khayo/SMG/PCI/Teclado/front.png

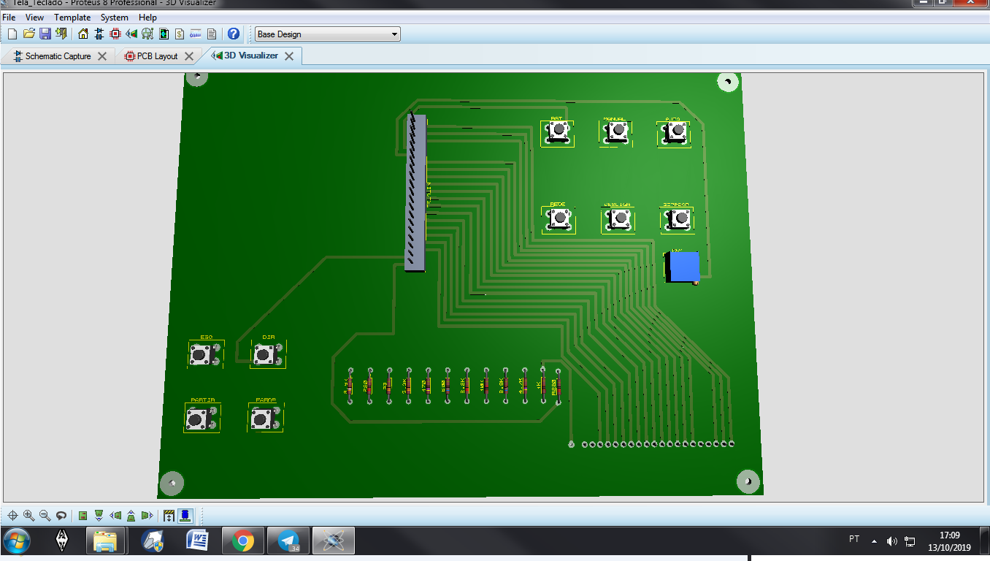
PCI/Teclado/front.png
