khayo/SMG/PCI/Teclado/PinDescription.jpg

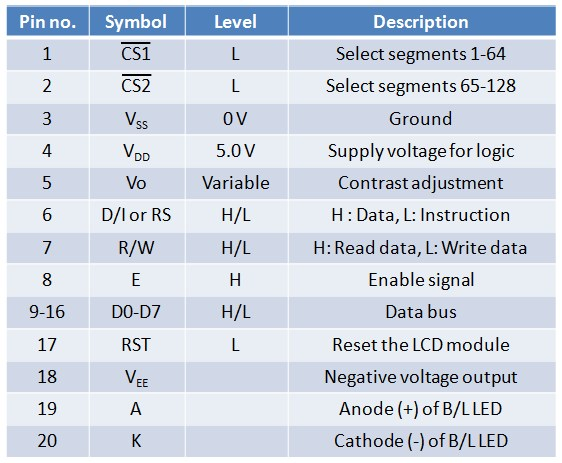
PCI/Teclado/PinDescription.jpg
