khayo/SMG/README.md

# SMG - Sistema de Monitoramento de Geradores

## Introdução

Projeto de conclusão de curso dos alunos do curso de eletroeletrônica da ETEC Lauro Gomes

## Integrantes
* Caio Pavan Lima dos Santos
* Guilheme Gil Farias Sousa
* Gustavo Vinícius de Oliveira Barros
* Khayo Vannucci Rodrigues
* Lucas Barros Silva

## Sobre o Projeto
Trata-se de um hardware de automação de geradores, tanto a parte física (placas e componente), quanto a parte lógica (software de controle) foram desenvolvidas por nós.

## Microcontrolado
Está sendo utilizadado o PIC18F4550, poís além de possuir uma grande quantidade de portas lógicas e alta velocidade de processamento (até 48mHz), possui suporte a comunicação USB, o que pode simplificar updates de Firmware no futuro.

## IDE
A IDE selecionada para desenvolver o projeto foi o MikroC devido a familiaridade dos membros com a ferramenta e a abundância de material disponível para consulta.

## Projeto Virtual
Para simulações está sendo utilizado o Software Proteus, também escolhido devido a familiaridade dos membros com a ferramenta.

## Projeto Físico
O Hardware está sendo desenvolvido em protoboard e após realização de testes de funcionamento, será montado em placa de circuito impresso.

## Monografia
Também está disponivel neste repositório a monografia, por onde mostraremos os passos do desenvolvimento do projeto.
