khayo/SMG/Programa/README.md

# SMG - Sistema de Monitoramento de Geradores
### Arquivos MikroC

Neste repositório estão armazenado o código-fonte e outros arquivos gerados pelo MikroC durante o desenvolvimento do sistema de controle.
