khayo/SMG/Simulacao/README.md

# SMG - Sistema de Monitoramento de Geradores
### Arquivos Proteus

Neste repositório estão armazenado os arquivos de projeto do Proteus.
