khayo/SMG/Academico/Monografia/README.md

# SMG - Sistema de Monitoramento de Geradores

## Monografia do projeto. 

Este é o arquivo da monografia do projeto.
