khayo/SMG/Layout/Layout_do_Modulo.png

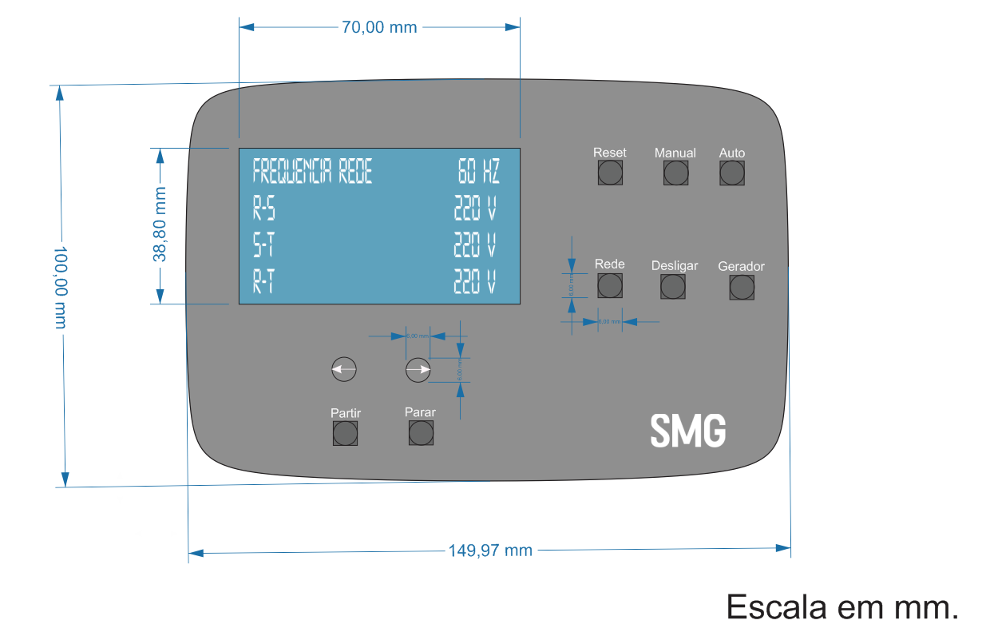
Layout/Layout_do_Modulo.png
