khayo/SMG/PCI/Teclado/1.png

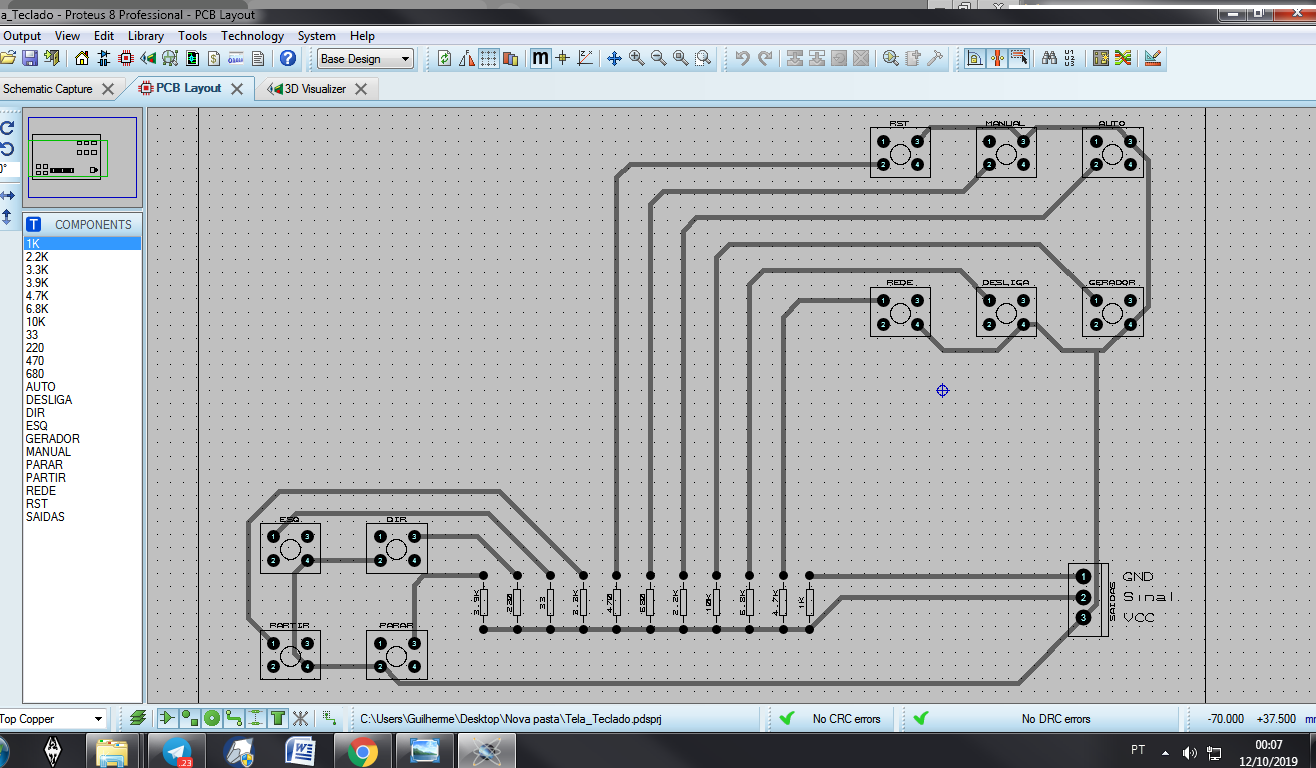
PCI/Teclado/1.png
