khayo/SMG/PCI/Teclado/back.png

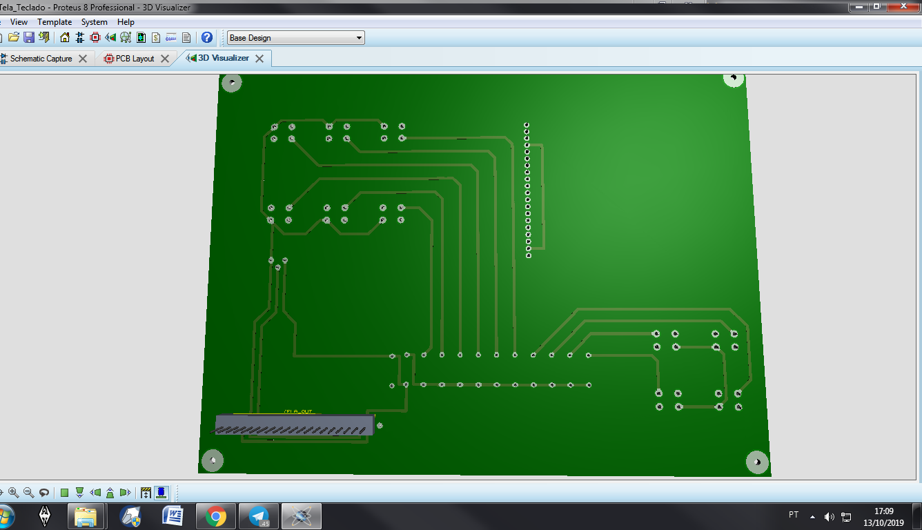
PCI/Teclado/back.png
