khayo/SMG/PCI/Teclado/layout.png

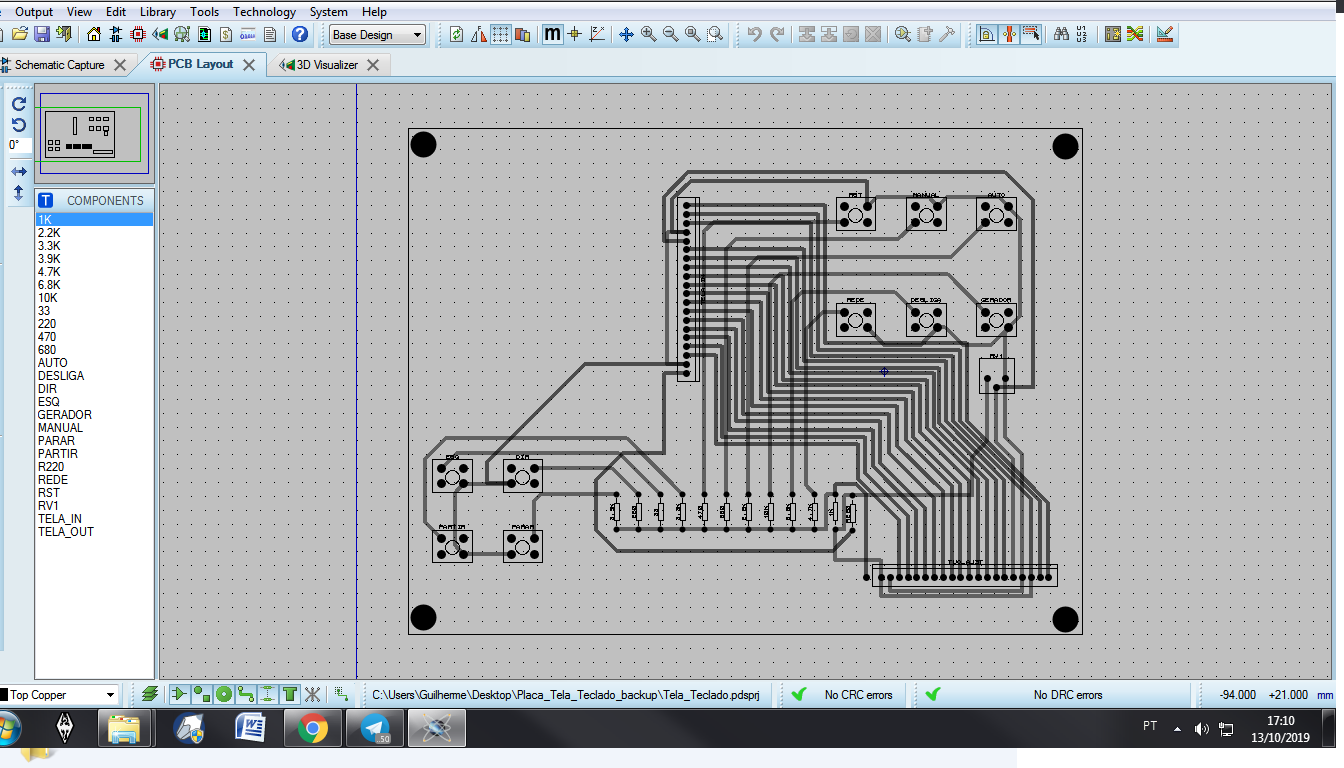
PCI/Teclado/layout.png
