khayo/SMG/Academico/Monografia/Planilha_de_Custos.xlsx

Lista de componentes
Componente | Qtd. | Valor | Subtotal
PIC18F4550 | 1 | R$31.00 | R$31.00
DISPLAY GRÁFICO K0105 | 1 | R$110.00 | R$110.00
RELE 12V | 4 | R$2.50 | R$10.00
BC548/BC549 | 4 | R$1.00 | R$4.00
DIODO 1N4007 | 4 | R$0.20 | R$0.80
PUSH BUTTON | 7 | R$0.40 | R$2.80
BOTÃO COM TRAVA | 2 | R$2.00 | R$4.00
TRIMPOT 10K | 1 | R$2.40 | R$2.40
LM35 | 1 | R$7.00 | R$7.00
LM7805 | 1 | R$1.40 | R$1.40
LM7812 | 1 | R$1.80 | R$1.80
DISSIPADOR | 2 | R$2.20 | R$4.40
PARAFUSO DISSIPADOR | 2 | R$0.30 | R$0.60
CRISTA OSCILADOR 20MHZ | 1 | R$1.00 | R$1.00
CAPACITOR CERAMICO 22PF | 2 | R$0.12 | R$0.24
CAPACITOR POLIESTER 10NF | 2 | R$0.80 | R$1.60
RESISTOR 4700 | 4 | R$0.20 | R$0.80
RESISTOR 33000 | 4 | R$0.20 | R$0.80
RESISTOR 1000 | 2 | R$0.20 | R$0.40
RESISTOR 33 | 1 | R$0.20 | R$0.20
RESISTOR 220 | 1 | R$0.20 | R$0.20
RESISTOR 470 | 1 | R$0.20 | R$0.20
RESISTOR 680 | 1 | R$0.20 | R$0.20
RESISTOR 10000 | 1 | R$0.20 | R$0.20
RESISTOR 4700 | 1 | R$0.20 | R$0.20
RESISTOR 2200 | 2 | R$0.20 | R$0.40
 |  |  | R$0.00
 |  |  | R$0.00
 |  |  | R$0.00
 |  |  | R$0.00
 |  |  | R$0.00
 |  |  | R$0.00
 |  |  | R$0.00
 |  |  | R$0.00
 |  |  | R$0.00
 |  |  | R$0.00
 |  |  | R$0.00
 |  |  | R$0.00
 |  |  | R$0.00
 |  |  | R$0.00
 |  |  | R$0.00
 |  |  | R$0.00
 |  |  | R$0.00
 |  |  | R$0.00
 |  |  | R$0.00
 |  |  | R$0.00
 |  |  | R$0.00
 |  |  | R$0.00
 |  |  | R$0.00
 |  |  | R$0.00
 |  | Total | R$186.64
