khayo/SMG/(threads)

Thread 1 (2019-10-06):

Layout do painel

khayo, 2019-10-06:
Necessário criação de layout do painel frontal do módulo contendo os botões de comando e visor. Botões presentes:

Seta para esquerda
Seta para direita
Reset
Manual
Automático
Partir
Parar
Rede
Desliga
Gerador

Em caso de dúvida, use este espaço para tirar dúvidas, dessa forma mantemos um histórico do desenvolvimento.
Caso se interesse por esta tarefa, responda esta Issue se compromentendo com sua execução. **Informar tempo necessário para desenvolvimento da tarefa.**
O layout deve ser entregue em formato de imagem, preferencialmente PNG.
Mais de uma pessoa pode se encarregar do desenvolvimento desta tarefa, tanto como um grupo, como individualmente.

Procure outros módulos ja existentes para ter uma ideia de como fazer, alguns exemplos de modulo. AMF25, HMI2011, DSE4610, DSE7410,

Conto com o engajamento de todos

DovahKrosis, 2019-10-06:
Vou tentar, só não prometo um Brad Pitt ! hehe

DovahKrosis, 2019-10-06:
tempo necessário para desenvolvimento da tarefa : 1 Hora

khayo, 2019-10-06:
Verificar tamanho do display ks0108 para que esteja na proporção correta
centralizar botões das setas
Melhorar distribuição dos botões
Agrupar corretamente os botões
Mehorar apresentação das fontes
--
Khayo Vannucci Rodrigues
11 98111-9785

Em dom, 6 de out de 2019 às 13:23, DovahKrosis <notifications@github.com>
escreveu:

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

khayo, 2019-10-06:
outros exemplos de módulo:
k30, dpc650, dkg 705

Lucfoxxd, 2019-10-07:
Feito Layout Frontal do Módulo. Está presente na pasta Layout

khayo, 2019-10-08:
OK @Lucfoxxd, acredito que [está seja a melhor disposição dos botões](https://github.com/khayo/SMG/blob/master/Layout/Layout_Frontal_do_Modulo_Lucas.png). Agora precisamos de uma versão **"em tamanho real"** com as medidas corretas dos botões e do display (ks0108). Vamos precisar mudar essas cores também, esse verde não está legal. Acho melhor uma cor mais neutra, tipo **cinza claro**. A cor do nosso **display é azul.** Acho que agora o Paint vai deixar a desejar, então procure alguém com **COMPROMISSO** e que vá te entregar essa tarefa **dentro do prazo** que escolheu para execução.

Caso alguém queira se encarregar dessa tarefa **até o fim**, informe o prazo necessário para **conclusão do trabalho.**

Lucfoxxd, 2019-10-08:
Como estou encarregado pela tarefa do layout do módulo para o Banner, então eu me encarrego desta tarefa e já adianto a outra na mesma proporção.

Prazo de entrega estimado: 12/10/19 (Sábado) até às 20h

Lucfoxxd, 2019-10-09:
Guilherme, você que tem botões, teria como me levar algum até sexta estourado?
Ou então me mandar a medida do botão que será usado no projeto (o que está na placa do layout que você executou).

khayo, 2019-10-09:
@lucfoxxd, usa o @ pra marcar e ele receber notificação

DovahKrosis, 2019-10-09:
levo um botão

Lucfoxxd, 2019-10-10:
Valeu, obrigado.
@khayo
@DovahKrosis

Lucfoxxd, 2019-10-10:
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
Atualizado Layout Frontal do Módulo. Preciso de vocês analisem e apontem melhorias o quanto antes para que eu possa colocar as medidas reais logo.
@Premone
@cplds
@DovahKrosis
@khayo

Lucfoxxd, 2019-10-10:
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
Medidas como estão por enquanto.

Lucfoxxd, 2019-10-10:
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
Atualizado Layout Frontal do Módulo. Preciso de vocês analisem e apontem melhorias o quanto antes para que eu possa colocar as medidas reais logo.
@Premone
@cplds
@DovahKrosis
@khayo

Lucfoxxd, 2019-10-10:
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
Medidas como estão.

Lucfoxxd, 2019-10-11:
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
Atualizado Layout Frontal do Módulo. Preciso de vocês analisem o quanto antes e deem suas opiniões e veredito.
@Premone
@cplds
@DovahKrosis
@khayo

Lucfoxxd, 2019-10-11:
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
Medidas reais. Analisem um possível erro.

DovahKrosis, 2019-10-11:
Muito bom em, eu aprovo

Lucfoxxd, 2019-10-11:
Então. Isso vai ser embutido na maleta, pelo o que eu entendi. Não vai ser um módulo tipo aquele que o Khayo mostrou para nós.

Lucfoxxd, 2019-10-11:
Eu também achei pequeno, seria o tamanho da placa. Mas pelo que entendi, é isso.

Lucfoxxd, 2019-10-11:
Esperemos o que vão dizer pra finalizar essa parte e vamos ver.

khayo, 2019-10-11:
Se esta imagem estiver com as proporções corretas, pode até mesmo diminuir a largura, pq ele está com aparência de achatado

Lucfoxxd, 2019-10-11:
A imagem não está na proporção correta

khayo, 2019-10-11:
Aí vc me complica né jovem. Acerta essas proporções pra gente definir o que fazer

Lucfoxxd, 2019-10-11:
Okay.

Lucfoxxd, 2019-10-11:
Farei isso

Lucfoxxd, 2019-10-12:
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
Acertado as medidas corretas e agora está proporcional. Pode conferir.
Escala em milímetros, mas, é só voltar uma casa decimal que é centímetro.

DovahKrosis, 2019-10-12:
Muito bom em mano, as proporções estão legais

Lucfoxxd, 2019-10-12:
Na outra tava bem achatado como o Khayo disse, tava sobrenado espaço de mais.

Lucfoxxd, 2019-10-14:
E aí, tá legal? Posso botar na monografia isso?

khayo, 2019-10-14:
Pode

Lucfoxxd, 2019-10-14:
Belezinha.

khayo, 2019-10-14:
Layout entregue em 13/10/2019 e0d3a0bcce2aa6c535c58c9038718beaaf7c645f

Closed 2019-10-14.

Thread 2 (2019-10-06):

Confecção de placa de rele

khayo, 2019-10-06:
Necessário confecção de **UMA** placa de rele conforme projeto [anexo](http://dicasdopinguim.com.br/wp-content/uploads/2019/10/placa_rele.zip).
Informações adicionais:
- Material será fornecido e entregue ao responsavel pela confecção no dia seguinte do aceite
- A placa deve ter 25mmx30mm
- Os contato NA e NF devem ser os bornes laterais
- Placa deve ser feita com **CAPRIXO**, pois integrará o modelo apresentado na semana da ETE

Algumas imagens de referencia de como deve ser a aparência final da placa neste [link](http://dicasdopinguim.com.br/wp-content/uploads/2019/10/placa_rele.zip)

Em caso de dúvidas, pergunte por aqui, para que possamos manter o histórico do desenvolvimento

**Informar prazo necessário para confecção**

Lucfoxxd, 2019-10-08:
Olá pessoa a qual está atribuída a tarefa. **Mande um prazo para entrega da tarefa totalmente FINALIZADA**, lembrando que **dentro desse prazo** será feita análise (todos os membros), revisão (todos os membros) e então quando aprovado, será entregue e marcada como concluída, portanto tentem não se perder na resolução da tarefa para não atrasar o desenvolvimento das outras partes que dependem desta tarefa para serem feitas.

**Qualquer dúvida, mande aqui!**

Lucfoxxd, 2019-10-10:
@cplds

cplds, 2019-10-10:
Tenho a placa já furada e desenhada, e vou levá-la hoje para resolver algumas considerações finais antes de corroer. Caso tudo dê certo, levarei-a montada amanhã.

Closed 2019-10-18.

Thread 3 (2019-10-06):

Projetar teclado do módulo

khayo, 2019-10-06:
Após definição do layout do painel do módulo, será necessário desenvolver o teclado.
A tarefa consiste em entregar um projeto de como deve ser o PCB do teclado

Algumas especificações

- Os **valores de resistor devem aparecer** no layout **corretamente** (consultar arquivo de projeto do proteus)
- A saída do teclado para o módulo deve **ter 3 fios**: positivo, negativo e comunicação.
- Os materiais devem ser **especificados e levantados por você**
- **Não confeccionar placa**, somente o projetar o designe para que seja aprovado

Em caso de dúvidas, pergunte por aqui, para que possamos manter o histórico do desenvolvimento

**Informar tempo necessário para desenvolvimento da tarefa.** Lembre-se, que este prazo é para entraga da tarefa **FINALIZADA**, ou seja, após **testes**, **análise** do material entregue e **aprovação** dos membros do grupo, portanto considere estes passos para **definir o prazo** para **finalização da tarefa**

Lucfoxxd, 2019-10-08:
Olá pessoal a qual estão atribuídos a tarefa. **Mandem um prazo para entrega da tarefa totalmente FINALIZADA**, lembrando que **dentro desse prazo** será feita análise (todos os membros), revisão (todos os membros) e então quando aprovado, será entregue e marcada como concluída, portanto tentem não se perder na resolução da tarefa para não atrasar o desenvolvimento das outras partes que dependem desta tarefa.

**Qualquer dúvida, mandem aqui!**

DovahKrosis, 2019-10-08:
PRAZO: QUINTA-FEIRA 10hAM

DovahKrosis, 2019-10-08:
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

DovahKrosis, 2019-10-08:
Os resistores estão com os valores na placa !

DovahKrosis, 2019-10-08:
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

Atualização Layout

DovahKrosis, 2019-10-09:
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

Atualizção Layout 2

DovahKrosis, 2019-10-09:
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

Atualização Layout 3

DovahKrosis, 2019-10-09:
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

Atualização 4

DovahKrosis, 2019-10-09:
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

Atualização 5

DovahKrosis, 2019-10-09:
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

Modelo Final Layout teclado

Closed 2019-10-09.

Thread 4 (2019-10-07):

Teste de consumo

khayo, 2019-10-07:
Fiz alguns testes para verificar o consumo do módulo e os resultados foram estes
O módulo em repouso, considerando a contatora de rede ligada, apenas com o display ligado, tem o consumo de 58mA.
Ao desligar a contatora da rede, temos 73mA (isto porque a contatora de rede está acionando na porta NF do relé)
Ao ligar contatora do gerador, temos 100mA.

Para cada rele acionado temos em torno de 25mA de aumento de consumo.
Então imaginando o "pior" cenário, onde todos os relés (5) estão acionados, temos 175mA.

Os reles que temos são, pre-aquecimento, solenoide de combustível, motor de partida. Achei bastante razoável. Provavelmente teremos aumento do valor do módulo em repouso ao adicionar os periféricos de controle de tensão.

Closed 2019-10-10.

Thread 5 (2019-10-07):

Banner

khayo, 2019-10-07:
Conforme já havia previsto, teremos a necessidade de criação de um banner explicando o o que é e o funcionamento de nosso projeto. Temos na nossa pasta da monografia, aquele inicio de banner, porem precisamos adicionar informações melhores no banner. Enviei aquele manual no telegram recentemente e acredito que ele traga informações muito boas para serem adicionadas no banner. Para fazer o banner usei a ferramenta [Spark Post](https://spark.adobe.com/pt-BR/) da Adobe, que é gratuita e traz diversas ferramentas que facilitam a edição deixando um trabalho bem bonito.

Acho que podemos seguir pela linha de algo mais voltado para o **profissional/comercial** ao invés de adotar uma abordagem acadêmica. Esta tarefa ficará bastante aberta, pois trata-se de desenvolvimento criativo.

Em caso de dúvidas, pergunte por aqui, para que possamos manter o histórico do desenvolvimento

**Informar tempo necessário para desenvolvimento da tarefa.** Lembre-se, que este prazo é para entrega da tarefa **FINALIZADA**, ou seja, após **testes**, **análise** do material entregue e **aprovação** dos membros do grupo, portanto considere estes passos para **definir o prazo** para **finalização da tarefa**

khayo, 2019-10-07:
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

Lucfoxxd, 2019-10-07:
Modelo de Banner

Lucfoxxd, 2019-10-07:
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
Banner Exemplo - 1

khayo, 2019-10-08:
Ficou definido da seguinte forma a divisão das tarefas do banner:
- Caio
  - Fluxograma simplificado
  - Nuvem de tags
- Gustavo
  - Imagem do display
  - Sensores
- Khayo
  - Lista
  - Características técnicas
  - Código C
  - Proteus
- Lucas
  - Logo
  - Perspectiva de layout frontal

Fazer cada parte individualmente, e enviar para análise antes de iniciar a próxima etapa
**Não importa qual ferramenta será usada** para desenvolver sua parte, o importante é que fique **bem definido o texto** que será usado e as **imagens que serão usadas**. Caso tenha algum bloquei criativo, não exite em procurar por materiais já existentes e **pedir ajuda** para outros membros. Solicite por reunião no **Discord** para **brainstorm**.
Precisamos acabar esta parte de design o mais rápido o possível, pois a **semana da ETE** é na próxima semana e portanto precisamos disto **o mais rápido o possível**, ainda precisaremos imprimir o banner.

khayo, 2019-10-08:
Criei as pastas para gente colocar os arquivos organizados, lembrem de dar git pull antes de começar a fazer as tarefas.

@Lucfoxxd - eu havia feito uma prévia de fontes, elas estão no telegram, no canal do tcc, de uma olhada para ter uma base de qual fonte usar, este é o site de onde peguei as fontes: https://fontmeme.com/ (usei como termo de busca, fonte larga).
Sobre Layout frontal, é bom agilizar a issue #1 para que usemos a versão finalizada no banner

@cplds - este site é bem simples para fazer fluxograma, mas se você tiver outro fique a vontade: https://www.draw.io
O site de nuvem de tags que usamos foi este aqui: http://www.abcya.com/word_clouds.htm

@Premone - em relação a foto do display, não sei devemos usar uma foto real do display que dificilmente vai ficar boa ou se devemos usar um print do display do Proteus. O que você acha melhor?
Sobre os sensor, acredito que o sensor mais "legal" para colocar, seja realmente o sensor de corrente, mas procure uma foto dele pela internet que as fotos que a gente tirou vão estragar o banner.

Conforme forem desenvolvendo, já enviem na pasta para que já iniciemos as analises e montagem do banner

**Lembrando que estamos correndo contra o tempo, precisamos ter esse banner pronto para semana da ETE que será na próxima semana**

khayo, 2019-10-08:
@Lucfoxxd, não se esqueça de criar o projeto para que você tenha controle do andamento do banner

khayo, 2019-10-08:
Pessoal, achei esta [ferramenta](https://www.befunky.com) que conta com alguns efeitos grátis bem interessantes, segue algumas imagens que tratei por ele para dar uma coisinha a mais:

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

Provavelmente usarei a imagem que está apenas virada, por estar bem limpa, mas não está aquela coisa "seca"

Lucfoxxd, 2019-10-08:
Como estou encarregado pela tarefa do layout do módulo para o Banner, medidas reais e ajustes para a parte física do módulo e a logo, então eu me encarrego desta tarefa e já adianto a outra na mesma proporção.

**Prazo de entrega estimado: 12/10/19 (Sábado) até às 20h**

khayo, 2019-10-09:
Voltamos a estaca zero com este banner agora que temos que seguir o modelo apresentado pelo professor. Alguém se habilita a fazer esta coisa horrorosa?

[Modelo Banner Padrão e Definitivo LauroGomes.pptx](https://github.com/khayo/SMG/files/3706904/Modelo.Banner.Padrao.e.Definitivo.LauroGomes.pptx)
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

Lucfoxxd, 2019-10-09:
Me habilito a fazer essa tarefa.
**Prazo estimado de entrega 12/10/19**

khayo, 2019-10-10:
Maravilha. Informação adicional obtida pelo grupo da sala (whatsapp) hoje. **O banner deve ter 90cm de altura por 60cm de largura**. Qualquer dificuldade nos comunique para que não fique preso a uma tarefa por muito tempo. Se posso **sugerir**, conforme for fazendo cada  parte vá nos **atualizando com o andamento**, desta forma podemos **otimizar o processo** de analise e revisão.

Lucfoxxd, 2019-10-12:
Vou utilizar alguns dados da Monografia para preenchimento de alguns campos, como, Introdução, Metodologia, Objetivos e Referências.

Lucfoxxd, 2019-10-12:
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
A **Introdução** falta melhor elaborar o paragrafo introdutório que acrescente no segundo.
**Objetivos** retirados em parte da monografia
Os **Resultados Obtidos** eu fiquei em dúvida e queria que vocês selecionassem as melhores imagens que evidencie um resultado significativo do funcionamento até agora do módulo @khayo, acho que você melhor tem autoridade para mandar essas fotos. (Duas, três)

Lucfoxxd, 2019-10-12:
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
A **Metodologia** eu pensei de fazer um fluxograma **por exemplo**: Pesquisa --> Aplicação do conhecimento --> Falha (Sim, não) --> (Não) Tirar dúvida com professores ou pesquisar mais.
As **Referências** eu peguei do nosso projeto principal(monografia), de onde a gente tirou boa parte da teoria.
A **Conclusão ou Considerações Finais** só será feita quando todo o resto estiver feito, revisado, finalizado e aprovado por vocês todos.

Lucfoxxd, 2019-10-12:
@cplds
@cplds
@DovahKrosis

Lucfoxxd, 2019-10-12:
**Analisem criticamente o que tem até agora, críticas são muito necessárias na escrita de um projeto**
Quando eu chegar verei tudo e concluirei o resto para análise de vocês.

khayo, 2019-10-12:
"mesmo"?

khayo, 2019-10-12:
Manda um print da página toda, fica mais fácil de ver

Lucfoxxd, 2019-10-12:
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

Lucfoxxd, 2019-10-12:
Vou alterar esse "mesmo", mania de principiante. Vou melhorar o termo

Lucfoxxd, 2019-10-12:
Até daqui a pouco.

Lucfoxxd, 2019-10-13:
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

Lucfoxxd, 2019-10-13:
Ae galera conforme prometido, eu voltei. Olhem e opinem.

DovahKrosis, 2019-10-13:
ta laegal, só esse estilo ai q é estranho mas é obrigatório né

Lucfoxxd, 2019-10-15:
É o jeito. Agr só esperar o cara confeccionar.

Closed 2019-10-18.

Thread 6 (2019-10-09):

Display

khayo, 2019-10-09:
Com o teclado finalizado (#3) e revisado, agora precisamos colocar o display nesta placa. Algumas **características do display**.
- 20 pinos
- faremos somente uma ligação simples do display com o teclado e do teclado com a placa principal **(display > teclado > placa principal)**.
- a barra de pinos fica do lado **DIREITO** do display
- o modelo do display é o **ks0108**
- **já existe gnd e Vcc** chegando na placa do teclado, não há necessidade de duplicar este sinal.
- o display conta com um **botão com trava para ligar o led de fundo** e um **trimpot para controle de intensidade** deste mesmo led. Podemos **embutir** estes controles na placa do teclado ou colocar na placa principal. Hoje o trimpot que está sendo usado é do **tipo de precisão**, podemos alterar para o modelo que é mais comumente usado para esta aplicação. Em relação ao botão de ligar o led de fundo, podemos trocar por uma **mini-chave liga/desliga**.

Agora precisamos decidir como vai ser a ligação da placa do teclado com a placa principal. Ou fazemos uma **ligação por cabo**, ou podemos ligar as placas como se a placa do teclado fosse um **cartucho (macho) ligando na placa principal (fêmea)**.  Precisamos levantar os **prós e contras** destes modelos de conexão ou ainda **levantar outras possibilidades** de ligação.

### Em caso de dúvidas, pergunte por aqui, para que possamos manter o histórico do desenvolvimento

**Informar tempo necessário para desenvolvimento da tarefa.** Lembre-se, que este prazo é para entrega da tarefa **FINALIZADA**, ou seja, após **testes**, **análise** do material entregue e **aprovação** dos membros do grupo, portanto considere estes passos para **definir o prazo** para **finalização da tarefa**

DovahKrosis, 2019-10-10:
"faremos somente uma ligação simples do display com o teclado e do teclado com a placa principal (display > teclado > placa principal)." essa ligação com o teclado eu não entendi.

khayo, 2019-10-10:
O display vai encaixar na placa do teclado.
O teclado vai encaixar na placa principal. Só isso

DovahKrosis, 2019-10-10:
ata blz

DovahKrosis, 2019-10-11:
tempo necessário para desenvolvimento da tarefa: SÁBADO ÁS 19:00 PM

Lucfoxxd, 2019-10-11:
Acho que a ligação em cartucho seria mais interessante porque não ficaria separado as duas partes e também ficaria mais fácil integrar os dois componentes.

DovahKrosis, 2019-10-11:
Lucfoxxd e sobre o botão com trava e o trimpot ?

khayo, 2019-10-11:
Eu gosto da ideia de cartucho, porém dessa forma, ficaremos com um "quadrado", na verdade um "L", o que dificulta no caso de chegarmos no ponto de criar a "caixa" para o módulo, e até mesmo para colocar o módulo na maleta. Apesar de que, podemos ligar como cartucho e converter para uma ligação de fio caso seja necessário. Levantei mais dúvidas do que soluções. Em resumo, acredito que a melhor solução seja mesmo a ligação "**cartucho**" pela **versatilidade**.

### O **prazo** para manifestação de opinião vai até **amanha as 15h****, após esse horário vou considerar o debate como **encerrado** e quem não participou como concordou com a maioria.

@DovahKrosis, adicione a placa, 4 furos para fixação de parafusos. Acredito que 5mm das bordas seja o suficiente e **DIAMETRO** de 3mm.

DovahKrosis, 2019-10-11:
Vou adicionar os furos, e esperar os comentarios restantes

Lucfoxxd, 2019-10-11:
@DovahKrosis
Pode ser usado essa chave liga e desliga. Se usasse o botão ocuparia menos espaço e seria mais viável?

Lucfoxxd, 2019-10-11:
Então @Khayo. Se utilizasse essa ligação em fio, caso a maleta for em acrílico, daria pra mostrar cada parte do componentes, mas teria fio rondando.

khayo, 2019-10-11:
A ligação de "cartucho" fica bem flexível, pq nada impede que seja ligado por jumpers tb

khayo, 2019-10-11:
Você e o @dovahkrosis vão ter que fazer esta parte em conjunto  para que isso funcione

Lucfoxxd, 2019-10-12:
Nesse caso então definido por cartucho.

DovahKrosis, 2019-10-12:
pessoal como apareceu ai eu criei **a pasta que conterá layout final da placa "Teclado/Tela"**, os layouts que antecederão a versão final serão colocados aqui, **se poderem opinem sobre** .

DovahKrosis, 2019-10-12:
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

**V1**

DovahKrosis, 2019-10-12:
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

**V2** O que vocês acham ?

khayo, 2019-10-12:
altere o tamanho da placa para o tamanho de placa que temos disponível (15x10)

khayo, 2019-10-12:
Alguns pontos para correção.

- Como disse na abertura da Issue, a placa ja possui Vcc e GND, logo **NÃO HÁ NECESSIDADE**  de existir o pino Vcc e GND em **duplicidade**.
- Conferir se os pinos do display estão corretos (KS0108)
- Colocar os nomes dos pinos
- Falta controle de contraste
- Falta chave de liga e desliga do backlight do display

khayo, 2019-10-12:
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

Lucfoxxd, 2019-10-12:
Na colocação do Dissipador de calor não vai interferir na montagem né?

khayo, 2019-10-12:
dissipador?

DovahKrosis, 2019-10-12:
Confira:
ENTRADAS DE TENSÃO: **VCC, VO, VEE, LED+.**

ENTRADAS **GND: GND, LED-.**

**O CONTROLE DE LUZ DE FUNDO FAZ NOS PINOS LED+/LED-?**
Eu não tenho o esquema de ligação da tela, mas se isso estiver certo da para fazer.

khayo, 2019-10-12:
http://embedded-lab.com/blog/lab-20-interfacing-a-ks0108-based-graphics-lcd-part-1/

DovahKrosis, 2019-10-12:
O prazo de entrega do layout da placa será redefinido quando tivermos as proporções da nova placa de fenolite dupla face.

khayo, 2019-10-14:
Vou procurar uma empresa de Santo André para fazer o orçamento da placa. Dependendo do valor vou mandar fazer

Lucfoxxd, 2019-10-14:
OK, avisa nós.

khayo, 2019-10-14:
Muito caro, R$850. Estou indo na santa Efigênia comprar fenolite dupla face maior pra fazer a placa na mão

khayo, 2019-10-14:
Tá na mão, vou tentar fazer hj a noite

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
![Uploading 20191014_134207.jpg…]()

Lucfoxxd, 2019-10-15:
Tranquilo!
14 out. 2019

khayo, 2019-10-18:
Estou procurando papel fotográfico para comprar, porém só encontrei papel fotográfico para impressora jato de tinta, acredito que não vai funcionar com este tipo de impressão. Quando conseguir o papel passo novas informações do andamento

Closed 2019-12-24.

Thread 7 (2019-10-10):

Controle de atualização

khayo, 2019-10-10:
Vou usar esta issue como controle de atualizações, desta forma podemos manter um histórico de fácil leitura das alterações realizada. A partir da próxima postagem, já começarei a listar as mudanças feitas, tentarei linkar ou intercalar a postagem com o commit realizado, não sei se é possível. Fiquem a vontade para tirar dúvidas ou sugerir melhorias.

khayo, 2019-10-10:
Realizei pequenas alterações no código para que o funcionamento no hardware ficasse dentro do esperado:
- Alteração do cálculo de temperatura
- Correção do posicionamento da exibição dos valores de calibração dos botões
- Travamento dos botões de navegação durante a calibração
- Melhoria na ativação do modo de calibração

khayo, 2019-10-10:
Ok, é possível referenciar o commit e intercalar com as postagens. Conseguiremos uma boa forma de controle. Estou também criando um projeto para que seja possível definir as tarefas necessárias (TODO)  para continuidade do desenvolvimento.

Lucfoxxd, 2019-10-10:
Continuo na mesma função desse projeto que você está criando?

khayo, 2019-10-11:
Você vai gerenciar e me cobrar como combinamos. Este final de semana estipularei os próximos passos a serem executados e pretendo ter um bom avanço para que tenhamos algo concreto para apresentar da semana. Peço a gentileza que não tire o "pinagem" desta Issue para que ela fique sempre na parte de cima da página.

khayo, 2019-10-11:
Fiz a compra de alguns componentes que prevejo que utilizaremos em brave, entre eles:
- Conectores DB25 macho e fêmea para PCI e para soldar fios. Acredito que esta será a interface entre nosso simulador e nosso módulo. (_090 L, M, N, O_)
- Barra de pinos fêmea 40 vias, para comunicação da placa principal com teclado (_090 H_)
- Barra de pinos macho 40 vias 90º para comunicação do teclado com a placa principal (_090 I_)
- Push Button Longo, além de facilitar os testes de protoboard, quando fecharmos o módulo, prevejo que eles serão necessários para que seja possível aperta-los. (_008_).
- Trimpot horizontal de 10, para controle da contraste do display, que será colocar na placa do teclado, caso seja definido que o trimpot ficará na placa do teclado. (_203B_)
- Separei do estoque a chave de liga e desliga para o led de fundo do display (_133_)

Em relação a parte lógica, não fiz nenhum progresso, pois com a chegada dos componentes, gastei um tempo adicionando os itens ao sistema.
Algumas fotos dos componentes e dos botões longos instalados na protoboard.
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

DovahKrosis, 2019-10-11:
muito legal esses push buttons altos

khayo, 2019-10-12:
Identifiquei quais são as rotinas prioritárias para o desenvolvimento do módulo e as coloquei no projeto "desenvolvimento principal".

Também fiz um levantamento das portas que estão sendo usadas e de quais portas estão disponíveis, e felizmente teremos portas o suficiente para continuar o desenvolvimento sem a preocupação de necessitar de mais portas (digitais e analógicas).

Estava fazendo algumas verificações no hardware e aconteceu algo estranho, o processamento estava acontecendo extremamente lento, isto nunca havia acontecido e fiz uma pequena revisão nas ligações e identifiquei uma conexão de fios positivos e negativos que não estavam muito bem encaixados. recoloquei os cabos e parece que está ok agora. Durante esta verificação notei que o LM35 foi ligado de maneira incorreta. Ainda não fiz a ligação correta, porem acredito que este seja o motivo da temperatura não estabilizar no display e também de existir divergências nos cálculos que deveriam ser feitos e os cálculos que estão sendo feitos.

Farei a correção do circuito e farei algumas alterações de portas usadas para que fiquem disponíveis portas analógicas para alguma eventualidade.

khayo, 2019-10-12:
Durante a revisão do projeto, notei que o cálculos que fiz para o divisor de tensão do sensor de tensão VCC estavam errados, na verdade estavam para o valor de 20v. Refiz os cálculos e alterei o divisor de tensão

khayo, 2019-10-12:
Finalizei a revisão da protoboard.

- Refeita ligações dos reles já instalado
- Feita ligação dos reles que não estavam instalados
- Correção das ligações do sensor de temperatura
- Correção dos cálculos e circuitos do divisor de tensão
Esta é a protoboard agora
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

Na primeira ligação houve um problema de funcionamento devido a ligação invertida do lm35. Aparentemente não houve dano aos componentes.

khayo, 2019-10-12:
Notei que após o módulo ficar parado em uma tela por um determinado tempo, os botões de navegação param de funcionar corretamente. imagino que seja algum tipo de excesso de processamento. Vou tentar descobrir o que está ocasionando a falha, após implementar algumas funções indispensáveis para a demonstração

khayo, 2019-10-12:
Após o envio do código sem comunicação serial, houve uma melhora no desempenho e o sistema parou de travar. Para o propósito do TCC, deixaremos esta função desativada.

khayo, 2019-10-12:
Atual disposição das portas:

2   - Sensor de temperatura (RA0)
3   - Botões (AN1/RA1)
4   - Sensor de tensão continua (AN2/AN2)
5   - Rele - pre-aquecimento (RA3/AN3)
6   - Rele - Solenoide (RA4)
7   - Rele - Motor de pártida (RA5/AN4)
8   - Rele - Gerador (RE0)
9   - Rele - Rede (RE1)
10  - Livre (RE2/AN7)
15  - Livre (RC0)
16  - Livre (RC1)
17  - Emergência (RC2)
23  - Livre (RC4)
24  - Livre (RC5)
25  - TX
26  - RX

Lucfoxxd, 2019-10-12:
Muito bom
Tem bastante informação pertinente para adicionar à monografia.

khayo, 2019-10-12:
Estou fazendo teste nos reles, configurei os botões reset, manual e automático, para acionar os reles pre-aquecimento, solenoide e motor de partida. Os reles solenoide e motos de partida estão funcionando como o esperado, porém o rele de pre-aquecimento está desligando ao acionar o rele de motor de partida e solenoide. A falha não se repete ao acionar o rele de rede ou de gerador. Vou verificar as ligações físicas, pois não vejo acredito que seja possível que seja uma fala de programação devido a simplicidade do código  (PRE_AQUEC = !PRE_AQUEC;)

khayo, 2019-10-12:
Outra informação importante é que o botão que liga o rele do pre-aquecimento não consegue desligar o pre-aquecimento

khayo, 2019-10-12:
Descobri o erro, o registrador ADCON1 estava configurado para portas analógicas de AN0 até AN3. Como fiz as alterações nas portas, a porta RA3 estava configurada como analógica, quando deveria ser digital. Fiz as alterações e está funcionando como esperado.

khayo, 2019-10-13:
O funcionamento "básico" do módulo está finalizado. Agora vem a parte de monitoramento de energia, que farei pelo Arduíno.

khayo, 2019-10-18:
Realizei alguns testes nos circuitos do projeto que estavam a algum tempo parados (gerador de função e comunicação serial) para verificar se estavam funcionando corretamente e está tudo funcionando como esperado. A partir de segunda me dedicarei a leitura de tensão, corrente e frequência de rede, espero no próximo final de semana trazer resultados concretos sobre o desenvolvimento desta parta.

khayo, 2019-10-19:
Durante o dia estive pensando nos materiais que teremos que comprar. Da parte de eletrônica, acredito que não tenha mais nenhum material para comprar, mas para a parte de elétrica, teremos que providenciar algumas coisas.
- [Contatoras WEG CAW04](https://produto.mercadolivre.com.br/MLB-1225736458-minicontator-weg-cawm4-40-00v26-220v-60hz-10045381-_JM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) (3 unidades).  (aquelas eram da AGESP, não podemos contar com elas)
- [Base Soquete para Rele](https://produto.mercadolivre.com.br/MLB-1220465906-base-soquete-porta-rele-5-4-pinos-40-amp-montavel-_JM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) (2 unidades)
- [Reles Automotivos](https://produto.mercadolivre.com.br/MLB-769337686-rel-auxiliar-automotivo-universal-12v-3040a-5-pinos-preto-_JM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) (2 unidades)
- Acrílico, acredito que o @DovahKrosis consiga pra gente

Hoje comprei uma peça para consertar minha impressora a laser, as peças devem chegar no meio da semana que vem, assim posso trabalhar com as PCI mais tranquilamente e sem a preocupação de ocorrer alguma falha no processo de impressão, perdendo o dia de trabalho.
O papel fotográfico estou estudando qual traz um melhor resultado, encontrei dois lugares que recomendaram o [Papel Fotográfico Epson 95g High Quality Inkjet S041117 100Fls](https://www.kalunga.com.br/prod/papel-especial-95g-high-quality-inkjet-fosco-s041117-epson/478693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). Pretendo comprar amanhã durante o dia.

Vi um vídeo ensinando como criar protocolos de comunicação, achei bem interessante e relativamente simples, se tivéssemos mais tempo, seria bem legal desenvolver um protocolo próprio, não por necessidade, mas pelo aprendizado. Então, continuamos com a comunicação serial mesmo, vou dar uma revisada no código do protótipo de comunicação e tentar fazer a comunicação propriamente dita.

khayo, 2019-10-20:
Ontem chegaram as peças da impressora laser que precisava ser arrumada. Troquei as peças e apanhei o dia todo dos drivers da impressora, mas finalmente deixei funcionando decentemente. Algumas fotos dos resultados:

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

Próximo passo é comprar o papel fotográfico, farei isto semana que vem, estou duro.

khayo, 2019-10-20:
O GitHub decidiu que vai colocar a foto de cabeça pra baixo, vai entender..

khayo, 2019-10-22:
Conversei com o Plez ontem, temos até o fim do mês de novembro para apresentar, podemos apresentar antes, o que provavelmente é uma ótima ideia, vou acelerar o desenvolvimento. FAÇAM ALGUMA COISA.

khayo, 2019-10-24:
Para melhorias futuras

https://youtu.be/oi3PKpMxIF8

khayo, 2019-10-26:
Comprei o papel para fazer as placas, vou revisar o layout e fazer os primeiros testes.
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

khayo, 2019-10-28:
Fiz a primeira placa pelo processo de transferência, os resultados não foram dos melhores, mas deu pra entender os pontos que precisam ser melhorados. Se usar o ferro frio, não transfere, muito quente corre o risco de danificar a placa. Além disso, mesmo com a placa dando errado, notei que seria bom aumentar o tamanho das trilhas, elas não ficaram ruins, mas alguns pontos poderiam não ter dado certo e se na placa for necessário fazer algum acerto com caneta antes da corrosão, com a trilha mais larga ficará mais fácil.
Notei tb que fazer cada lado individualmente provavelmente não vai dar certo. Agora como fazer as duas ao mesmo tempo vai ser um desafio, ainda estou pensando em uma solução.

No geral as ilhas ficaram muito boas, exceto algumas trilhas dos botões, mas nada que fosse impossibilitar o uso da placa.

Acredito que durante a semana eu consigo fazer a placa.
Algumas fotos de como ficou.
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

khayo, 2019-10-28:
Fiquei pensando em como fazer para transferir os dois lado de uma vez, e pensei no furo guia, já tinha antes mas acabou sumindo por algum motivo, e agora tem de novo. Além disso coloquei um jumper  no trimpot de contraste, achei que assim ficaria melhor para soldar na barra de pinos.

DovahKrosis, 2019-10-28:
ou na placa ta escrito Janeiro 2017, não é 2018 ???

khayo, 2019-10-29:
> ou na placa ta escrito Janeiro 2017, não é 2018 ???

Fiz a alteração conforme o commit 5fe8169. Iniciei o processo de manufatura da placa, hj corte e limpei. Pretendo amanhã fazer as trilhas e corroer.

Closed 2019-12-24.

Thread 8 (2019-10-12):

Arquivos em duplicidade

khayo, 2019-10-12:
Pessoal, estamos em uma plataforma de c**ontrole de versão**, pelo amor de deus, **não dupliquem arquivos**, caso queira fazer alguma alteração, simplesmente faça a alteração e envie para o github. Caso seja necessário restaurar o arquivo como ele estava anteriormente é possível fazer isso através do git. Ao duplicar arquivos, além de grandes chances de essas versões se perderem na linha do tempo, perdemos o controle de versão do arquivo, ainda ocupamos espaço desnecessariamente.

Closed 2019-10-18.

Thread 9 (2019-10-15):

Apresentação na semana da ETE

Lucfoxxd, 2019-10-15:
Temos algumas especificações para a apresentação do projeto na semana da ETE que será realizada no dia 16/10/19, quarta-feira:

1. O banner será apresentado na direção junto com uma apresentação referente ao projeto, onde os professores vão dar a nota numa ficha que deveremos imprimir, preencher a nossa parte e levar para eles preencherem o resto.

2. Será necessários pelos menos duas ou três pessoas na direção para apresentação aos professores **segundo o Fialho**. As pessoas que não estiverem na diretoria, estarão no bloco 5 explicando o projeto, eu **sugiro imprimir algumas fichas que fizemos referentes ao projeto para nortear a apresentação** quem for ficar na sala do bloco 5 para entregar as pessoas.

3. Salas em que vão ficar no bloco 5 e os professores que vão avaliar, se informar qual das salas vão ficar, segue a imagem:
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

4. Cada grupo tem que receber no mínimo três avaliações de três professores onde essa ficha será passada ao orientador que é o Plez.

5. Devemos imprimir 3 conjuntos dessas fichas **segundo informações passadas pelo Whatsapp** para que os professores possam gerar a notas.
Segue as folhas da ficha:

**Folha 1**
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

**Folha 2**
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

**Folha 3**
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

6. A tarefa atribuída será definir **quem irá ficar no bloco 5 e os temas que serão divididos para apresentar aos professores tanto na diretoria quanto no bloco 5**, pois se  todos tiverem que apresentar juntos por algum problema, todos sabem o conteúdo/falas e o que está acontecendo exatamente em ambos os locais da apresentação.

**7. Como o prazo está super apertado, a urgência é definir tudo até amanhã o mais cedo possível para ter tempo de ensaiar a apresentação e evitar erros desnecessários.**

khayo, 2019-10-15:
Por mim tanto faz, eu to tranquilo quanto a apresentação, pode me mandar onde for mais complicado

Lucfoxxd, 2019-10-15:
Tudo bem então. Vou separar.

Lucfoxxd, 2019-10-15:
Fica eu, Khayo e mais uma pessoa para apresentar na banca para os professores.
O Guilherme sugeriu a seguinte:
Lucas, Khayo e Gustavo para os professores.
Caio e Guilherme lá na diretoria.
Eu concordo com essa divisão.

Sobre as questões que foram apresentadas ontem, a dúvida de apresentar todo mundo junto ou não é uma possibilidade de acontecer.

Vou dividir os seguintes temas que ficará tanto pras três pessoas quanto para as duas (tentar apresentar em pelo menos 15 minutos pra não ficar cansativo):

1 INTRODUÇÃO
2 OBJETIVOS
3 METODOLOGIA
4 PROBLEMAS RESOLVIDOS, ENCONTRADOS E DIFICULDADES EM EXECUTAR O PROJETO ATÉ O MOMENTO
5 RESULTADOS OBTIDOS ATÉ AGORA
6 CONCLUSÃO

(A divisão é simples o 6 é múltiplo de 3 e de 2 então os membros ficarão com as mesmas quantidades tanto em um bloco, quanto no outro se ocorrer isso mesmo)

**O que eu preciso de vocês agora é:**
- Quem vai imprimir uma ficha e preencher, e imprimir pelo menos uns 3 panfletos daqueles que foram feitos pelo Khayo.
- E preciso que dividam o que cada um irá falar (tanto as duas pessoas, quanto as 3), para já treinar a apresentação. (Escolham seus temas)
- E preciso também da divisão caso se todos fossem apresentar juntos. (Escolha seu tema, nesse caso, uma pessoa irá ficar com dois temas)

**Os professores irão tirar dúvidas, então quaisquer dúvidas sobre o projeto até aqui, é bom tirar o quanto antes no grupo do Telegram ou aqui mesmo na Issue**

Temos a Monografia, o arquivo do Alterações Pendentes e o Banner para se basear em conteúdo.

Lucfoxxd, 2019-10-15:
Temas Lucas Para três pessoas: Introdução e Conclusão.
Temas Lucas para 5 pessoas: Introdução

**Façam nesse modelo**

Eu já separei os meus. Se precisar mudar, nós mudamos sem problema.

Closed 2019-10-18.

Thread 10 (2019-10-18):

Resultados semana da ETE

khayo, 2019-10-18:
Primeira fase concluída, fizemos uma boa apresentação.
Vamos tirar este final de semana para descansar e pegamos forte novamente semana que vem.
Não podemos levar esta segunda fase como fizemos na primeira, todos precisaram contribuir mais ativamente no projeto para que possamos entregar o trabalho realmente concluído.

Alguns pontos que precisamos melhorar:

-**Iniciativa**: Não esperem que eu peça para que façam algo, vocês conhecem o projeto e ele também é de vocês. Vocês estão perdendo  uma boa oportunidade de aprender. Eu sei o quanto me desenvolvi nestes últimos tempos por conta desse projeto.
-**Prazos**: Temos pouco tempo, dediquem uma parte do tempo de vocês pensando em como melhorar o que apresentamos. Existem ideias idiotas, mas pelos prazos, até elas são bem vindas.
-**Qualidade**: Não podemos nos dar ao luxo de ter retrabalho. Se algo está sendo feito, faça com atenção, para fazer uma vez só.
-**Capricho**: Pode ser que este não seja o projeto que vocês tinham na cabeça para fazer, mas é este que escolhemos, quando estiver fazendo algo relacionado ao projeto, lembre do que sentiu quando recebeu elogios, queira receber mais elogios e faço um bom trabalho.
-**Pense**: Todos nós temos um cérebro, use-no para entregar um bom resultado
-**Comunique**: Somos 5 pessoas trabalhando no mesmo projeto, se não houver uma comunicação clara, termos sérios problemas. Antes de dar andamento a alguma parte do projeto que será feita por terceiros, confirme se o material que está sendo entregue ao fornecedor é o material correto para que não exista falhas na comunicação.
-**Dedique-se**: Este é o trabalho mais importante do ano, é de suma importância que se dediquem a ele.
-**Experimente**: "ah, mas eu não sei o que fazer", a vida é assim, não sabemos o que fazer mesmo, sentar e esperar cair a resposta no colo não se mostrou uma boa estratégia. Aqui, agora, vocês tem a chance de experimentar decisões com um custo muito, **MUITO** baixo. Não percam esta chance.

É isso pessoal, conto com a colaboração de todos.

Closed 2019-10-28.
