khayo/SMG/Academico/Monografia/Diagrama de funcionamento Gerador.pdf

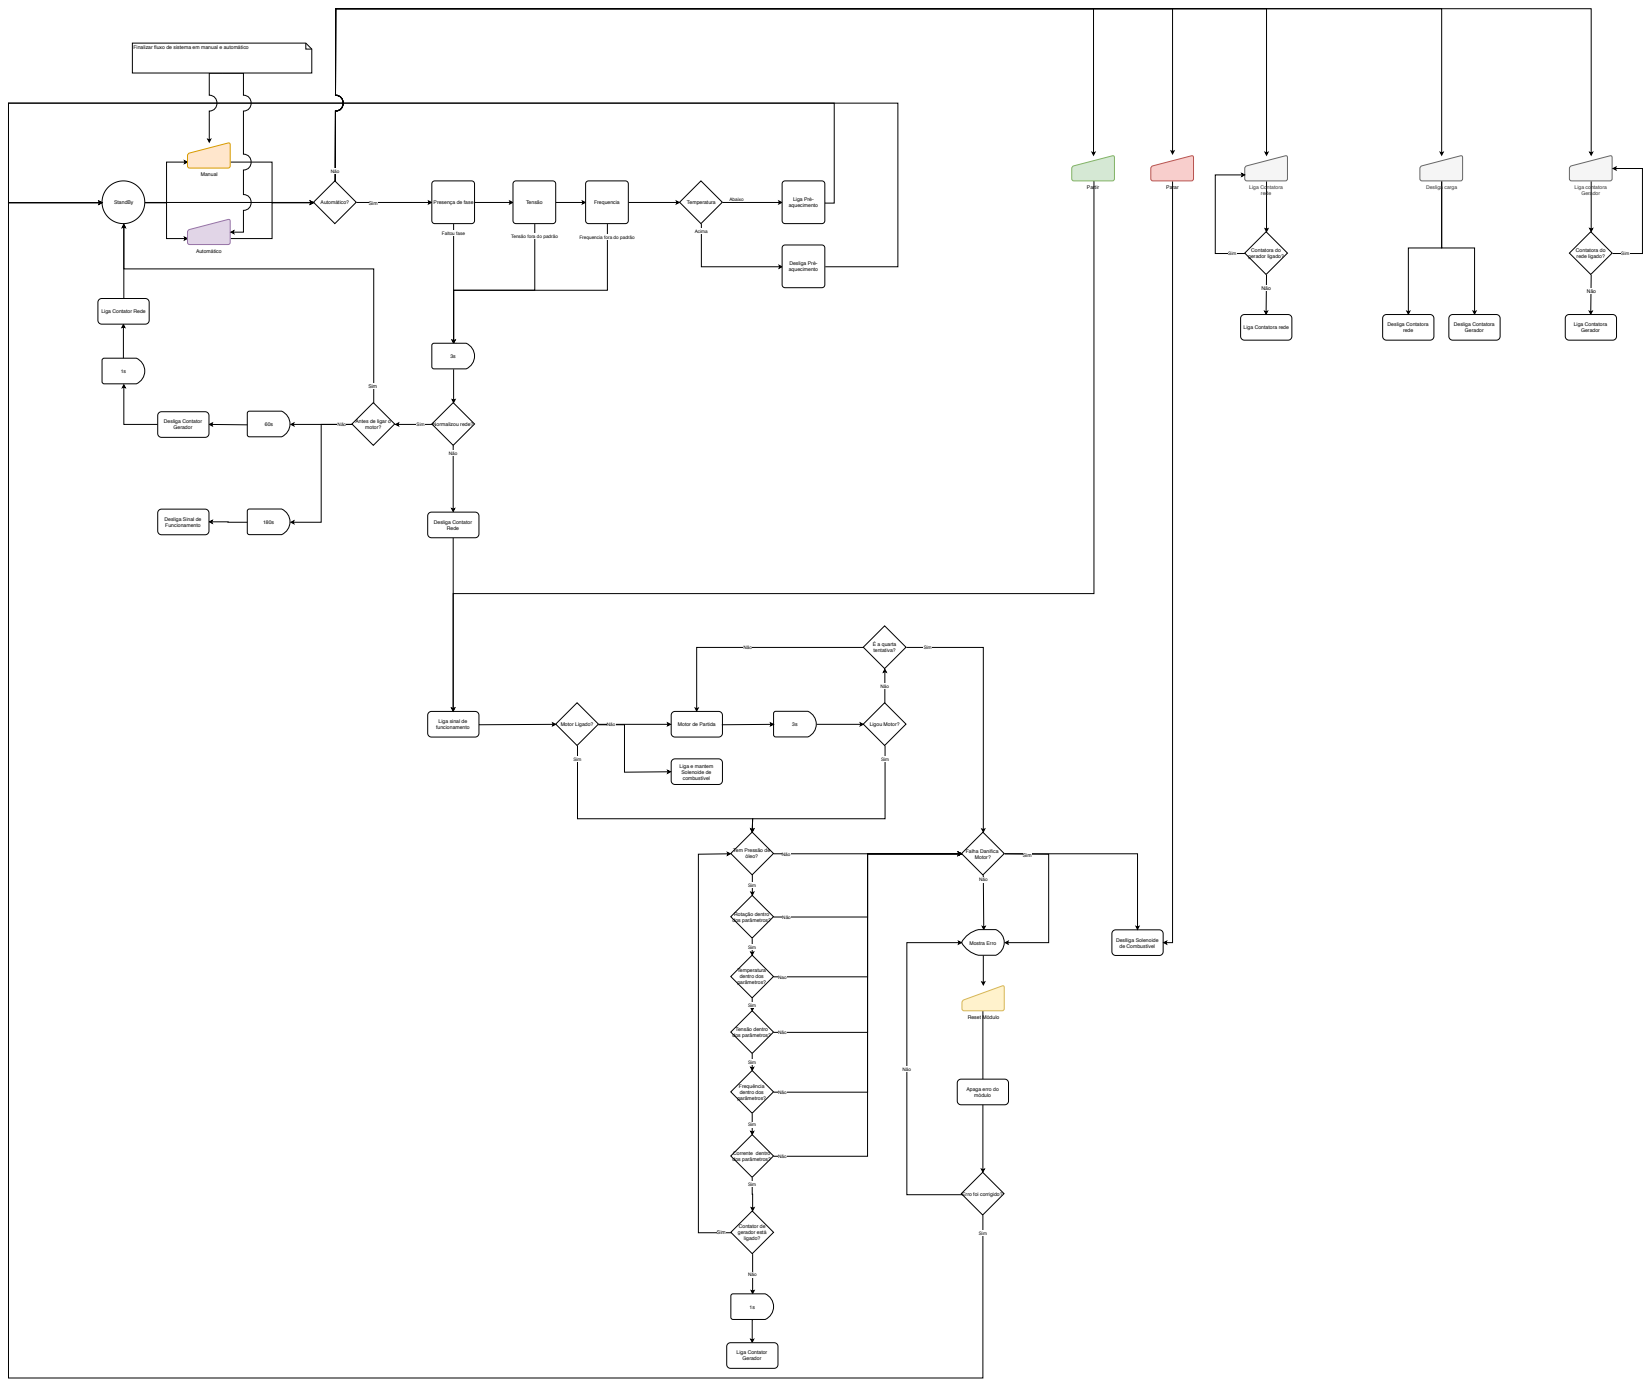
[picture p7: page 1]
Liga e mantem Solenoide de combustível; Sim; Não; Rotação dentro dos parâmetros?; Nao; Temperatura dentro dos parâmetros?; Tensão dentro dos parâmetros?; Frequência dentro dos parâmetros?; StandBy; Faltou fase; Tensão; Frequencia; Acima; Abaixo; Temperatura; Desliga Pré- aquecimento; Liga Pré- aquecimento; Falha Danifica Motor?; Deslliga Solenoide de Combustível; Normalizou rede?; Motor Ligado?; Ligou Motor?; É a quarta tentativa?; Mostra Erro; Reset Módulo; Corrente dentro dos parâmetros?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

Finalizar fluxo de sistema em manual e automático

Presença de fase

Tensão fora do padrão

Frequencia fora do padrão

Liga Contator Rede

Liga Contatora rede

Antes de ligar o

180s Desliga Sinal de
Funcionamento

Liga sinal de
funcionamento

Motor de Partida

Tem Pressão de
óleo?

Apaga erro do
módulo

Erro foi corrigido?
