khayo/SMG/(list of files, drawings)

Other design files:
PCI/Botoes/Teclado.pdsprj
PCI/Placa_rele/placarele.pdsprj
PCI/Placa_rele/placarele_copias.pdsprj
PCI/Teclado/Tela_Teclado.pdsprj
Simulacao/TCC.pdsprj
