khayo/SMG/PCI/Placa/TCC.kicad_pcb

## KiCad design PCI/Placa/TCC.kicad_pcb (2019-12-24)

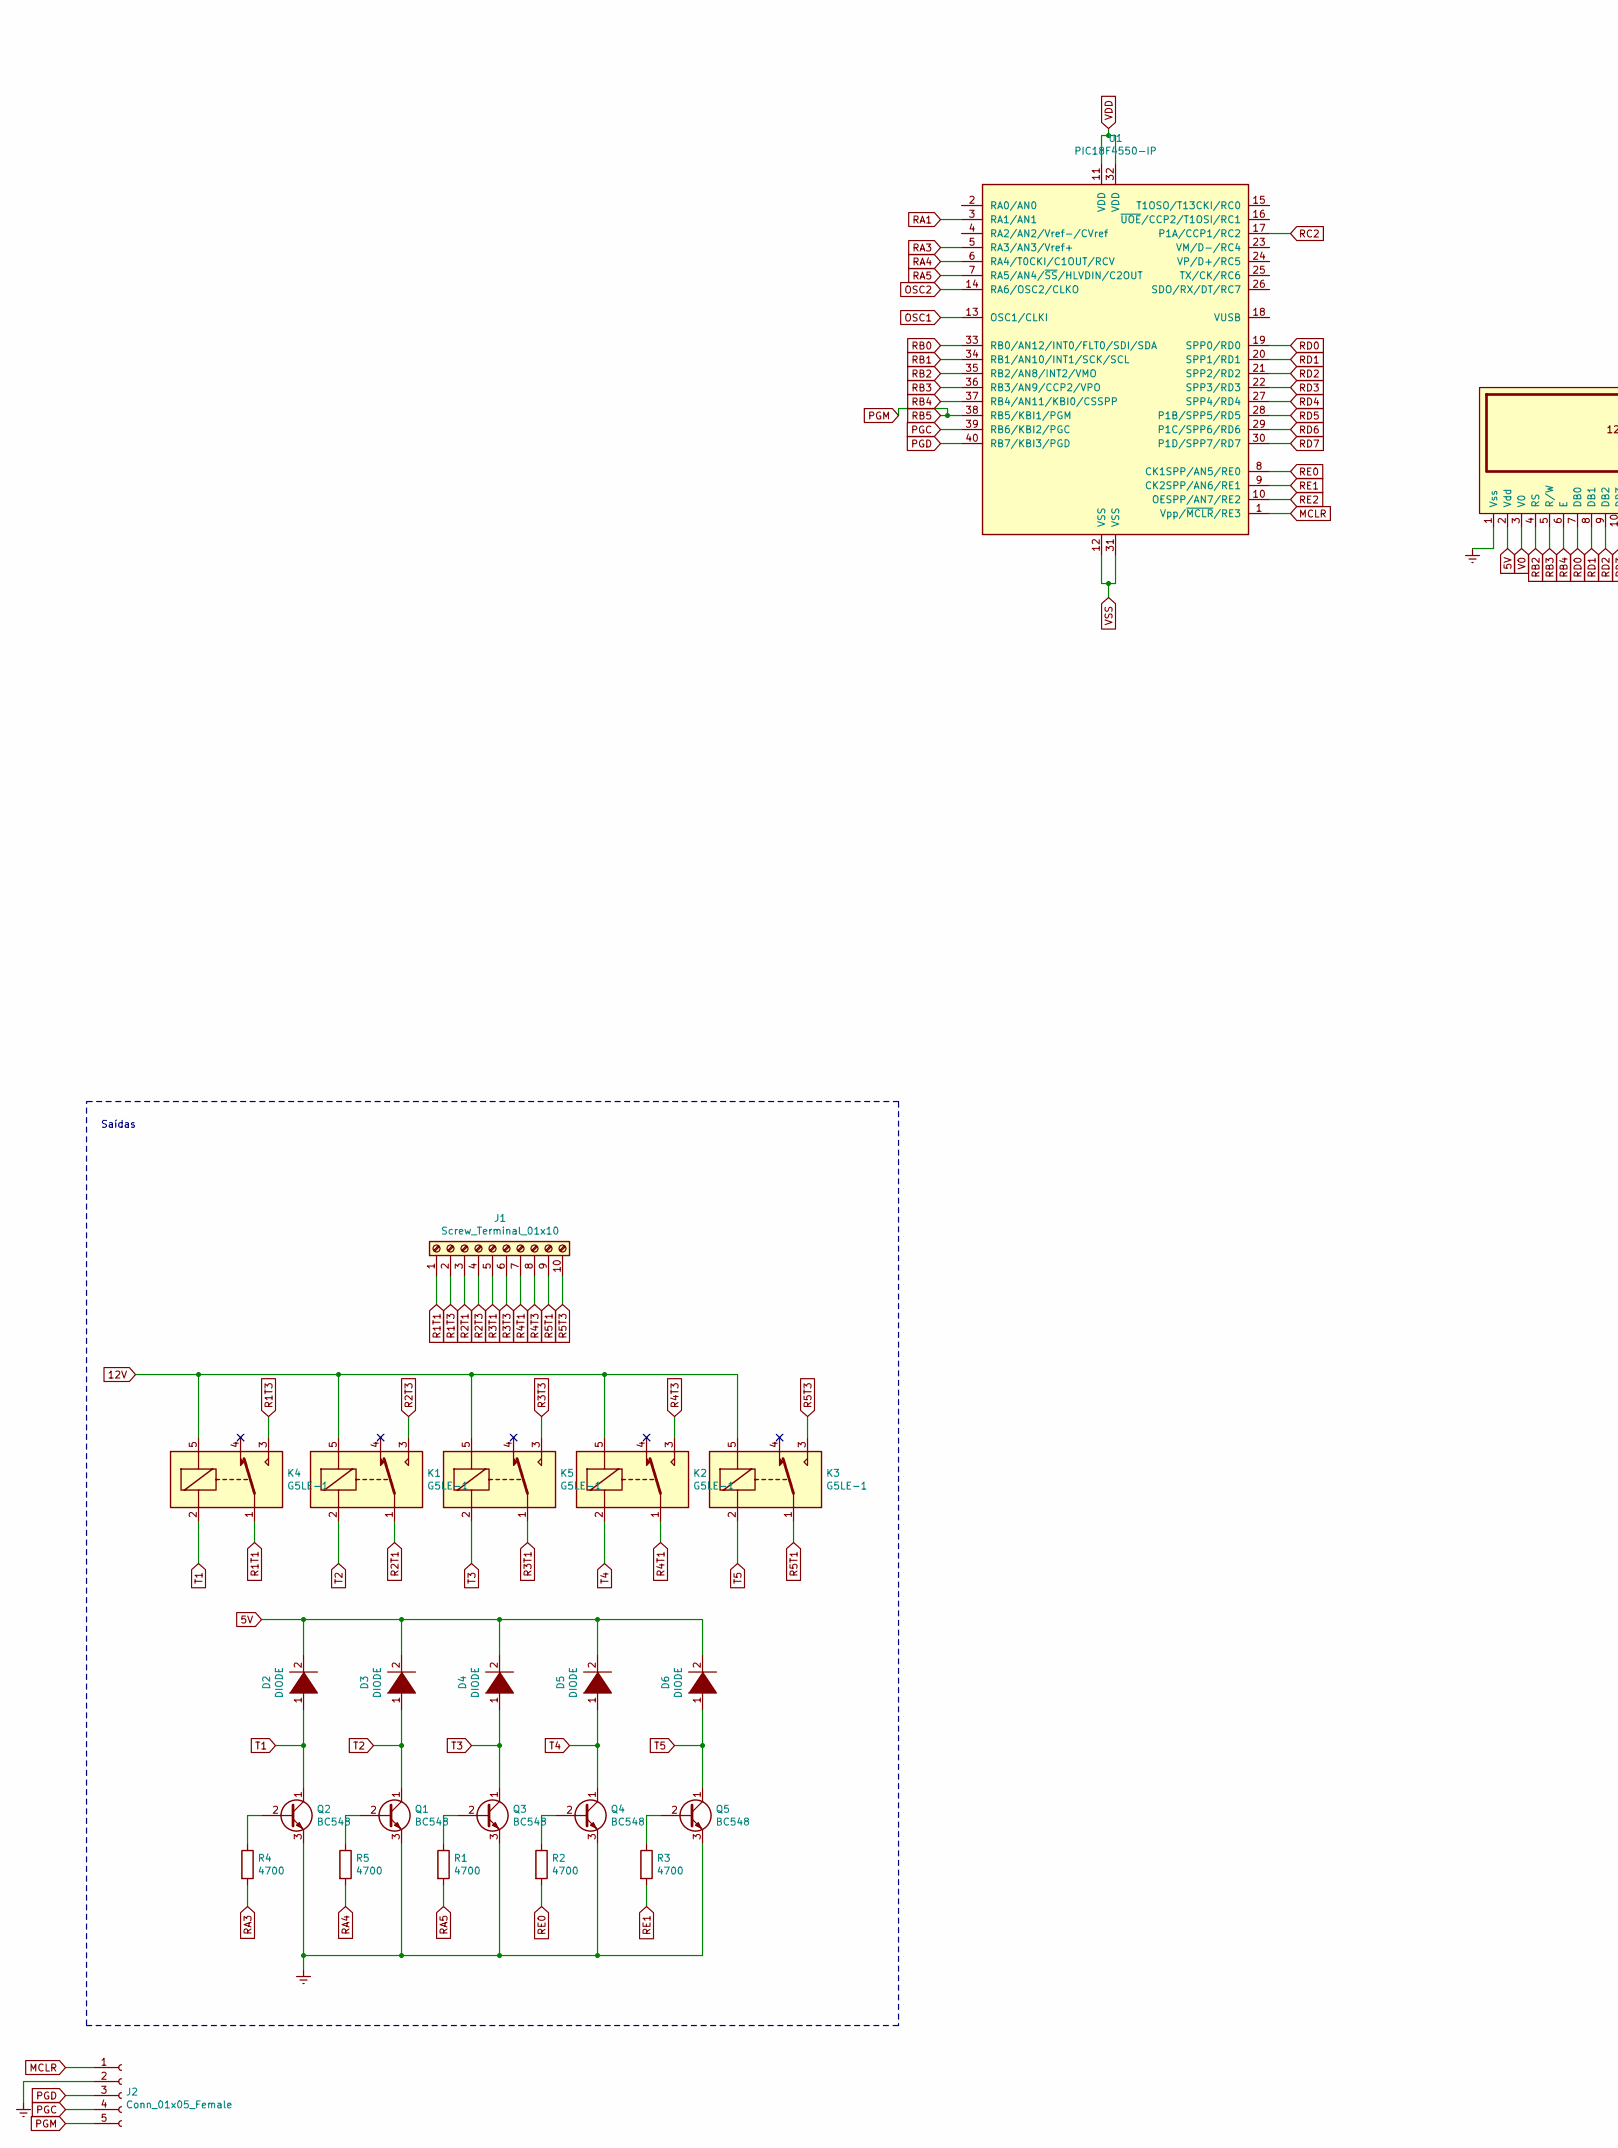
[picture p8: schematic TCC.sch, TCC Eletroeletrônica, part in row 1, column 1]

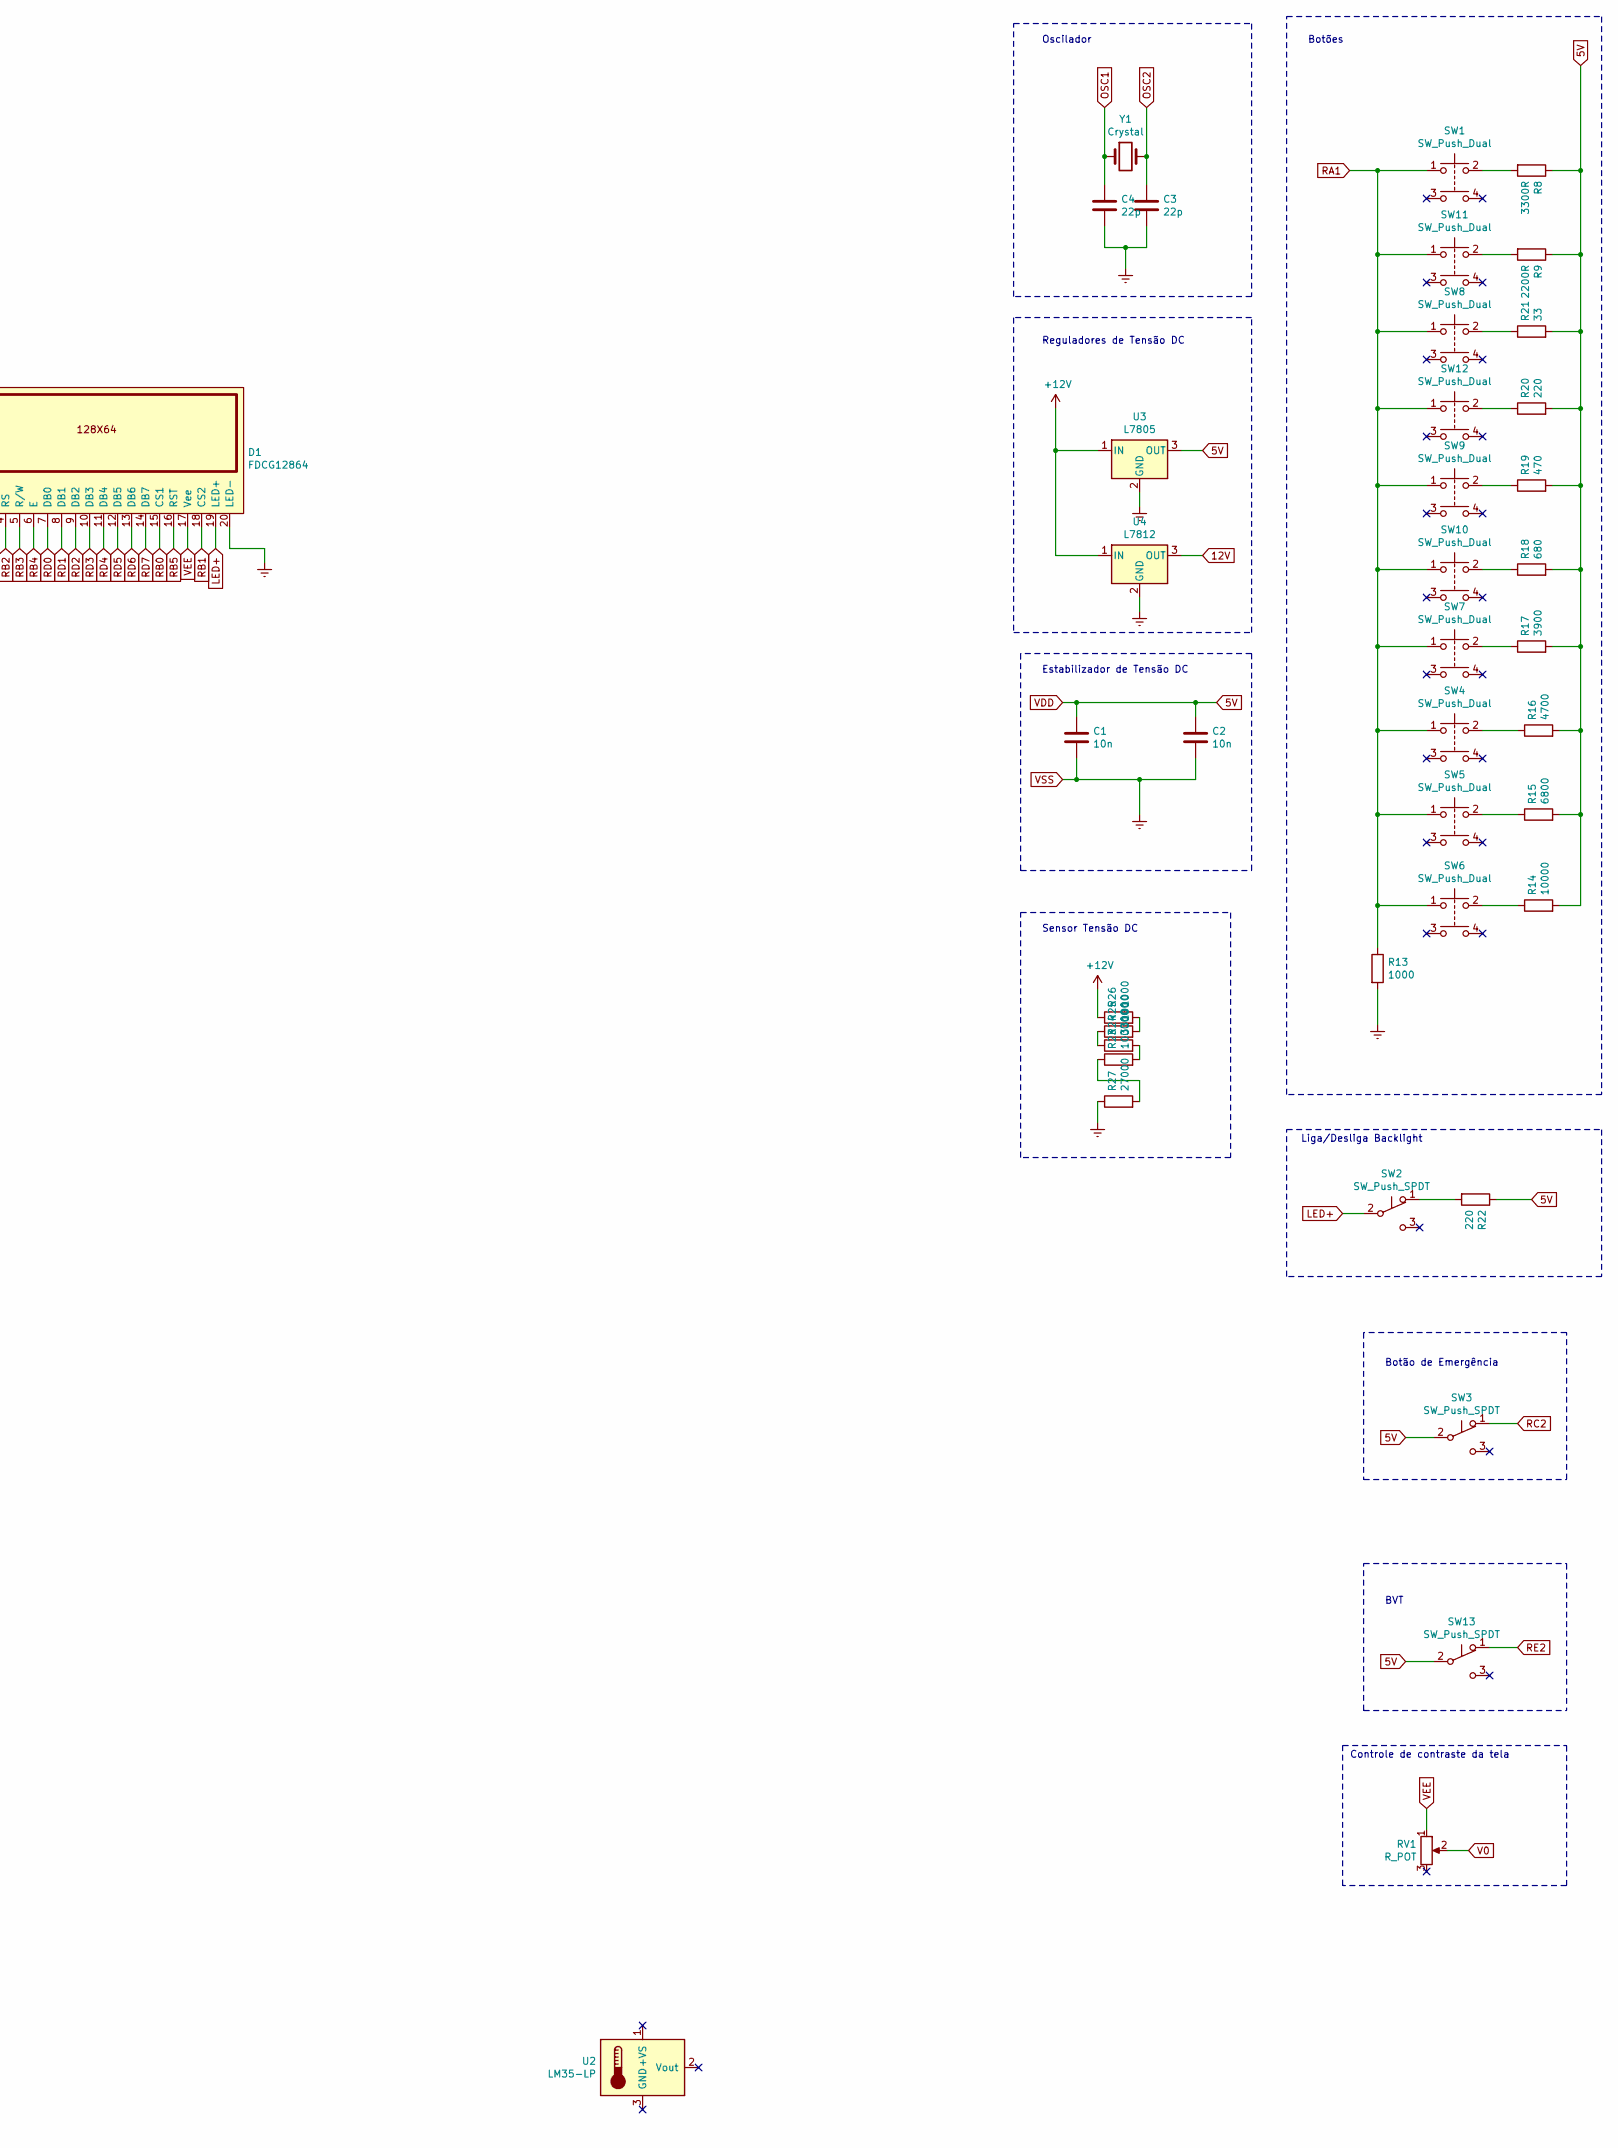
[picture p9: schematic TCC.sch, TCC Eletroeletrônica, part in row 1, column 2]

Parts:
C1, C2: 10n; C_Rect_L7.0mm_W2.5mm_P5.00mm
C3, C4: 22p; C_Disc_D3.0mm_W1.6mm_P2.50mm
D1: FDCG12864; FDCG12864G
D2, D3, D4, D5, D6: DIODE; D_A-405_P7.62mm_Horizontal
J1: Screw_Terminal_01x10; TerminalBlock_4Ucon_1x10_P3.50mm_Horizontal
J2: Conn_01x05_Female; PinSocket_1x05_P1.00mm_Vertical
K1, K2, K3, K4, K5: G5LE-1; Relay_SPDT_Omron-G5LE-1
Q1, Q2, Q3, Q4, Q5: BC548; TO-92_Inline
R1, R2, R3, R4, R5, R16: 4700; R_Axial_DIN0204_L3.6mm_D1.6mm_P5.08mm_Horizontal
R8: 3300R; R_Axial_DIN0204_L3.6mm_D1.6mm_P5.08mm_Horizontal
R9: 2200R; R_Axial_DIN0204_L3.6mm_D1.6mm_P5.08mm_Horizontal
R13, R25, R26: 1000; R_Axial_DIN0204_L3.6mm_D1.6mm_P5.08mm_Horizontal
R14: 10000; R_Axial_DIN0204_L3.6mm_D1.6mm_P5.08mm_Horizontal
R15: 6800; R_Axial_DIN0204_L3.6mm_D1.6mm_P5.08mm_Horizontal
R17: 3900; R_Axial_DIN0204_L3.6mm_D1.6mm_P5.08mm_Horizontal
R18: 680; R_Axial_DIN0204_L3.6mm_D1.6mm_P5.08mm_Horizontal
R19: 470; R_Axial_DIN0204_L3.6mm_D1.6mm_P5.08mm_Horizontal
R20, R22: 220; R_Axial_DIN0204_L3.6mm_D1.6mm_P5.08mm_Horizontal
R21: 33; R_Axial_DIN0204_L3.6mm_D1.6mm_P5.08mm_Horizontal
R23: 100000; R_Axial_DIN0204_L3.6mm_D1.6mm_P5.08mm_Horizontal
R24: 33000; R_Axial_DIN0204_L3.6mm_D1.6mm_P5.08mm_Horizontal
R27: 27000; R_Axial_DIN0204_L3.6mm_D1.6mm_P5.08mm_Horizontal
RV1: R_POT; Potentiometer_Bourns_3006P_Horizontal
SW1, SW4, SW5, SW6, SW7, SW8, SW9, SW10, SW11, SW12: SW_Push_Dual; SW_PUSH_6mm_2_Contatos
SW2, SW3, SW13: SW_Push_SPDT; SW_E-Switch_EG1224_SPDT_Angled
U1: PIC18F4550-IP; DIP-40_W15.24mm
U2: LM35-LP; TO-92
U3: L7805; TO-220-3_Vertical
U4: L7812; TO-220-3_Vertical
Y1: Crystal; Crystal_HC18-U_Vertical

Connections:
5V: C1.1, C2.1, D1.2 (Vdd), D2.2 (A), D3.2 (A), D4.2 (A), D5.2 (A), D6.2 (A), R8.1, R9.1, R14.2, R15.2, R16.2, R17.2, R18.2, R19.2, R20.2, R21.2, R22.1, SW3.2 (B), SW13.2 (B), U1.11 (VDD), U1.32 (VDD), U3.3 (OUT)
12V: K1.5, K2.5, K3.5, K4.5, K5.5, U4.3 (OUT)
+12V: R26.1, U3.1 (IN), U4.1 (IN)
LED+: D1.19 (LED+), SW2.2 (B)
MCLR: J2.1, U1.1 (Vpp/~MCLR~/RE3)
unnamed: Q1.2 (B), R5.1
unnamed: Q2.2 (B), R4.1
unnamed: Q3.2 (B), R1.1
unnamed: Q4.2 (B), R2.1
unnamed: Q5.2 (B), R3.1
unnamed: R8.2, SW1.2
unnamed: R9.2, SW11.2
unnamed: R14.1, SW6.2
unnamed: R15.1, SW5.2
unnamed: R16.1, SW4.2
unnamed: R17.1, SW7.2
unnamed: R18.1, SW10.2
unnamed: R19.1, SW9.2
unnamed: R20.1, SW12.2
unnamed: R21.1, SW8.2
unnamed: R22.2, SW2.1 (A)
unnamed: R23.1, R27.2
unnamed: R23.2, R24.2
unnamed: R24.1, R25.1
unnamed: R25.2, R26.2
OSC1: C4.1, U1.13 (OSC1/CLKI), Y1.1
OSC2: C3.1, U1.14 (RA6/OSC2/CLKO), Y1.2
PGC: J2.4, U1.39 (RB6/KBI2/PGC)
PGD: J2.3, U1.40 (RB7/KBI3/PGD)
PGM: D1.16 (RST), J2.5, U1.38 (RB5/KBI1/PGM)
R1T1: J1.1, K4.1
R1T3: J1.2, K4.3
R2T1: J1.3, K1.1
R2T3: J1.4, K1.3
R3T1: J1.5, K5.1
R3T3: J1.6, K5.3
R4T1: J1.7, K2.1
R4T3: J1.8, K2.3
R5T1: J1.9, K3.1
R5T3: J1.10, K3.3
RA1: R13.1, SW1.1, SW4.1, SW5.1, SW6.1, SW7.1, SW8.1, SW9.1, SW10.1, SW11.1, SW12.1, U1.3 (RA1/AN1)
RA3: R4.2, U1.5 (RA3/AN3/Vref+)
RA4: R5.2, U1.6 (RA4/T0CKI/C1OUT/RCV)
RA5: R1.2, U1.7 (RA5/AN4/~SS~/HLVDIN/C2OUT)
RB0: D1.15 (CS1), U1.33 (RB0/AN12/INT0/FLT0/SDI/SDA)
RB1: D1.18 (CS2), U1.34 (RB1/AN10/INT1/SCK/SCL)
RB2: D1.4 (RS), U1.35 (RB2/AN8/INT2/VMO)
RB3: D1.5 (R/W), U1.36 (RB3/AN9/CCP2/VPO)
RB4: D1.6 (E), U1.37 (RB4/AN11/KBI0/CSSPP)
RC2: SW3.1 (A), U1.17 (P1A/CCP1/RC2)
RD0: D1.7 (DB0), U1.19 (SPP0/RD0)
RD1: D1.8 (DB1), U1.20 (SPP1/RD1)
RD2: D1.9 (DB2), U1.21 (SPP2/RD2)
RD3: D1.10 (DB3), U1.22 (SPP3/RD3)
RD4: D1.11 (DB4), U1.27 (SPP4/RD4)
RD5: D1.12 (DB5), U1.28 (P1B/SPP5/RD5)
RD6: D1.13 (DB6), U1.29 (P1C/SPP6/RD6)
RD7: D1.14 (DB7), U1.30 (P1D/SPP7/RD7)
RE0: R2.2, U1.8 (CK1SPP/AN5/RE0)
RE1: R3.2, U1.9 (CK2SPP/AN6/RE1)
RE2: SW13.1 (A), U1.10 (OESPP/AN7/RE2)
T1: D2.1 (K), K4.2, Q2.1 (C)
T2: D3.1 (K), K1.2, Q1.1 (C)
T3: D4.1 (K), K5.2, Q3.1 (C)
T4: D5.1 (K), K2.2, Q4.1 (C)
T5: D6.1 (K), K3.2, Q5.1 (C)
V0: D1.3 (V0), RV1.2
VEE: D1.17 (Vee), RV1.1
VSS: C1.2, C2.2, C3.2, C4.2, D1.1 (Vss), D1.20 (LED-), J2.2, Q1.3 (E), Q2.3 (E), Q3.3 (E), Q4.3 (E), Q5.3 (E), R13.2, R27.1, U1.12 (VSS), U1.31 (VSS), U3.2 (GND), U4.2 (GND)

Notes on the sheet:
BVT
Botão de Emergência
Botões
Controle de contraste da tela
Liga/Desliga Backlight
Sensor Tensão DC
Estabilizador de Tensão DC
Reguladores de Tensão DC
Oscilador
Saídas

Board: 2 copper layers, 63 parts (0 on the bottom side), 69 nets, no tracks yet.
