khayo/SMG/(commit log)

2019-09-28 Primeiro envio dos arquivos
    [MyProject.cfg, TCC.cfg, TCC.pdsprj]
2019-09-28 teste de commit feito pelo lucfoxxd
2019-09-29 correção de erros de grafia
2019-09-29 Instrução para dar aula.
2019-09-29 Alterado o arquivo readme para sua versão correta.
2019-09-29 Alterado para conter a prova final do lucas
2019-09-29 correção dos erros de ortografia do arquivo README.md
2019-09-29 Update Alterações_pendentes.docx
    Removido sensor de frequência e pressão da monografia
2019-09-29 teste do docx2txt e alteração do nome dos arquivos para evitar erro
2019-09-29 teste de git, sem pasta attibutes
2019-09-29 teste de git sem docx2txt pelo notebook
2019-09-29 Arquivo de aula git
2019-09-29 texto de teste no aula_git guilherme
2019-09-29 texto de teste no aula_git gustavo
2019-09-29 texto de teste do aula_git Caio
2019-09-29 ateste para dar merge
2019-09-29 utro ero para ser arrumado
2019-09-29 apagado arquivos de projeto desnecessários
    [MyProject.cfg]
2019-10-01 Ajustado calculo de temperatura do LM35
    [TCC.pdsprj]
2019-10-01 Adicionada planilha de custos a pasta monografia
    [Planilha de Custos.xlsx]
2019-10-02 Alterado nome d arquivo para nao conter espaços
    [Planilha_de_Custos.xlsx]
2019-10-02 Teste do xlsx txt
    [Planilha de Custos.xlsx, Planilha_de_Custos.xlsx]
2019-10-02 teste script
    [Planilha_de_Custos.xlsx]
2019-10-02 teste depois de reiniciar
    [Planilha_de_Custos.xlsx]
2019-10-02 corrigida valor da planilha de custo
    [Planilha_de_Custos.xlsx]
2019-10-03 Adicionado folheto de apresentação do módulo
2019-10-03 Adicionado gitignore
    [TCC.pdsprj]
2019-10-03 Adicionado git ignore em cada pasta
    [TCC.pdsprj]
2019-10-03 Alterado gitignore da pasta proteus
    [TCC.pdsprj]
2019-10-03 Configuração final do gitignore
    [TCC.pdsprj]
2019-10-03 Adicionado reles de pre-aque, partida, sol. combustivel
    [TCC.pdsprj]
2019-10-06 Enviada primeira versão do fluxograma de funcionamento do gmg
2019-10-06 Adicionado e reorganizado botões do painel do modulo
    [TCC.pdsprj]
2019-10-06 Atualizado conteúdo: sensor de temp, drive e correções.
2019-10-06 Alterada pasta layout e folheto para estarem na raiz do repositório
    [TCC.pdsprj]
2019-10-06 Adicionado lógica para os botões novos reset, manual, auto, parte, parar
    [TCC.c]
2019-10-07 Ajustado linhas tortas e adicionado função de manual e automatico
2019-10-08 criação das pastas para desenvolvimento do banner
2019-10-08 imagens e texto prévio para o tópico "proteus" do banner
2019-10-09 Adicionado Pasta teclado
    [teclado smg.pdsprj]
2019-10-09 Alterações feitas no layout do teclado
    [teclado smg.pdsprj]
2019-10-09 adicionado atualização de trilhas
    [teclado smg.pdsprj]
2019-10-09 teclado com layout corrigido
    [teclado smg.pdsprj]
2019-10-09 Alterada trilha torta do botão partir
    [teclado smg.pdsprj]
2019-10-09 Alterado nome do arquivo para nao conter espaço
    [teclado smg.pdsprj, teclado_smg.pdsprj]
2019-10-09 Teclado finalizado e revisado. Closes #3.
    [teclado_smg.pdsprj]
2019-10-10 Corrigido posição e funcionamento da função de calibração
    [TCC.c]
2019-10-12 Alterada porta do sensor vcc de AN3(5) para AN2(4)
    [TCC.cfg, TCC.pdsprj]
2019-10-12 Ajuste do calculo de temperatura
2019-10-12 Corrigido valores do divisor de tensão so sensor vcc
    [TCC.pdsprj]
2019-10-12 Correção do calculo de VCC. #7
2019-10-12 adicionado pasta placa_tela_tecaldo.#6
    [Tela_Teclado.pdsprj]
2019-10-12 Corrigido código para que o valor de temperatura não pisque. #7
    [TCC.c]
2019-10-12 Desativei temporariamente as funções de comunicação serial #7
2019-10-12 Correção da tensão de entrada do sensor de Vcc
    [TCC.pdsprj]
2019-10-12 atualização do layout da placa tela teclado V2.#6
    [Tela_Teclado.pdsprj]
2019-10-12 removido pasta teclado
    [teclado_smg.pdsprj]
2019-10-12 deletada a pasta tela teclado.#6
    [Tela_Teclado.pdsprj]
2019-10-12 removido mais entradas que se comunivacam por serial. #7
2019-10-12 Adequação do simulador para nova disposição das portas. #7
    [TCC.pdsprj]
2019-10-12 Melhoria na distribuição dos itens. #7
    [TCC.pdsprj]
2019-10-12 alterado local onde o calculo do sensor de temp. é corrigido #7
    [TCC.c]
2019-10-12 adicionado teclado tela layout.#6
    [Tela_Teclado.pdsprj]
2019-10-12 Adicionada rotinas para pre-aquecimento. #7
2019-10-13 adicionada rotinas de funcionamento auto/manual. #7
2019-10-13 Adicionado indicador de modo (manual / Auto). #7
2019-10-13 adicionado rotina para ligar e desligar solenoide de combustivel. #7
2019-10-13 Adicionada rotina de motor de partida. #7
2019-10-13 Adicionada rotinas de partida e parada de GMG. #7
2019-10-13 Adicionado variavel de status do gerador. #7
2019-10-13 Adicionado controles e condiçoes de partida do motor. #7
2019-10-13 Adicionado rotina de desligamento do pre-aquecimento na partida. #7
2019-10-13 atualização do layout da placa tela/teclado.#6
    [Tela_Teclado.pdsprj]
2019-10-14 Teclado e display, ligaçoes ok, necessário melhorias. #6
    [Tela_Teclado.pdsprj]
2019-10-14 Corrigido trilhas. #6
    [Tela_Teclado.pdsprj]
2019-10-14 Inicio do desenvolvimento do monitor de energia. #7
2019-10-14 Fonte de edição do layout em tamanho real.
2019-10-14 Adicionado fonte de edição do layout em tamanho real.
2019-10-14 Adicionado layout frontal para visualização.
2019-10-14 Teclado certo
    [Tela_Teclado.pdsprj]
2019-10-15 Adicionado e fizalizado o banner (Arquivo para visualização)
2019-10-15 adicionado trimpot na placa tela/teclado.#6
    [Tela_Teclado.pdsprj]
2019-10-16 Correção de trilhas do trimpot. #6
    [Tela_Teclado.pdsprj]
2019-10-27 Revisão da placa do telcado para impressão #7
    [Tela_Teclado.pdsprj]
2019-10-27 Versão final para impressão da PCI, com ilhas alteradas. #7
    [Tela_Teclado.pdsprj]
2019-10-27 Ultima versão com trilha alterada. Pronto para impressão. #7
    [Tela_Teclado.pdsprj]
2019-10-28 Trilhas mais largas, jumpers no trimpot. #7
    [Tela_Teclado.pdsprj]
2019-10-28 Adicionado furos guia. #7
    [Tela_Teclado.pdsprj]
2019-10-28 Corrigida a data e versão do hardware. #7
    [Tela_Teclado.pdsprj]
2019-10-31 Corrigidas marcas de alinhamento. #7
    [Tela_Teclado.pdsprj]
2019-11-02 Adcionado conteúdos que etão pendentes (Parte 1/2)
2019-11-02 Adicionado conteúdos que estão pendentes (Parte 1/2).
2019-11-02 Adicionado conteúdos que estavam pendentes (Parte 2/2).
2019-11-15 monitoramento de falha BVT. #7
2019-11-15 retorno de rede implementado; #7
    [TCC.pdsprj]
2019-11-21 Placa de reles das saídas. #7
    [placarele.pdsprj, placarele_copias.pdsprj]
2019-11-23 Adicionado conteúdo sobre módulo controlador de gerador.
2019-11-23 Adicionado conteúdo: layout do teclado, painel de contato.
2019-11-25 teclado sem visor. #7
    [Teclado.pdsprj]
2019-11-27 versão do código finalizada para apresentação. #7
    [TCC.pdsprj]
2019-12-24 Arquivos de projeto da PCI
    [TCC.kicad_pcb, TCC.sch]
2019-12-24 Reorganização dos arquivos
    [Planilha_de_Custos.xlsx, TCC.cfg, TCC.kicad_pcb, TCC.pdsprj, TCC.sch, Teclado.pdsprj, Tela_Teclado.pdsprj, placarele.pdsprj]
2019-12-24 Apagado arquivos usados para ensinar o uso do git/github
